preal97/VMCB/Doku/BACKSIDE.PNG

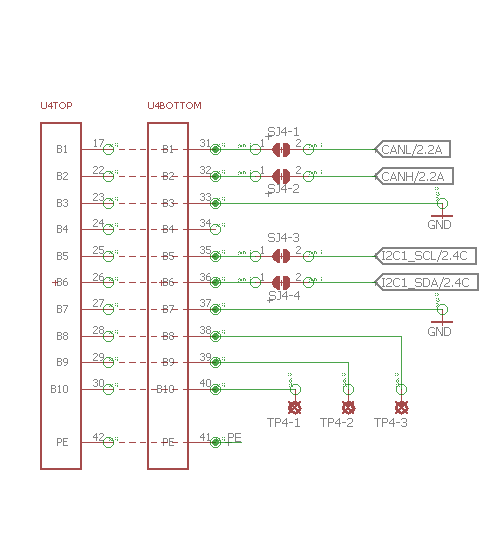
Doku/BACKSIDE.PNG
