preal97/VMCB/Doku/CANDIP.PNG

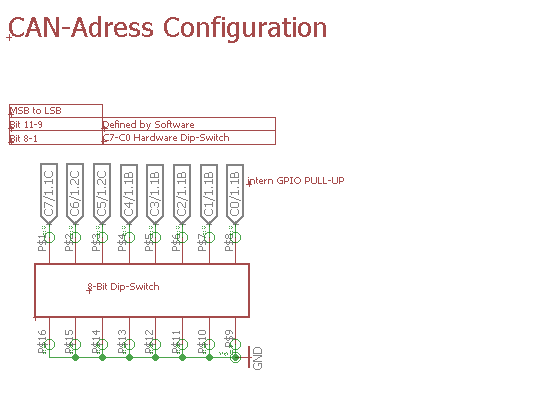
Doku/CANDIP.PNG
