preal97/VMCB/Doku/LED.PNG

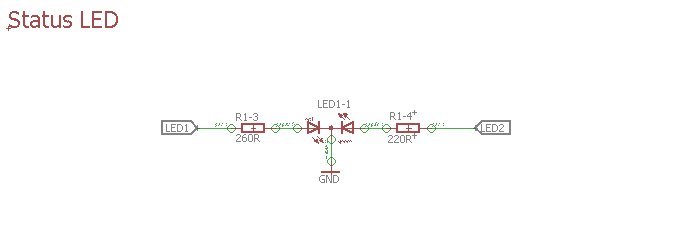
Doku/LED.PNG
