preal97/VMCB/Doku/MAX.PNG

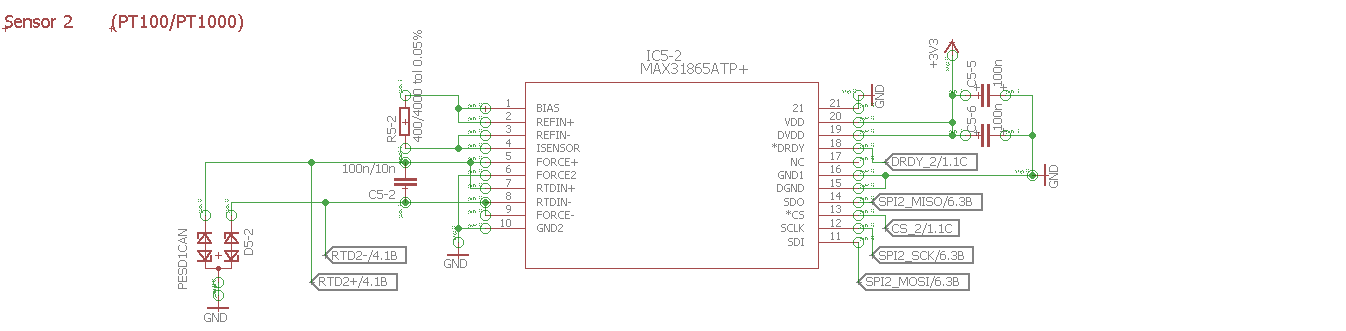
Doku/MAX.PNG
