preal97/VMCB/Doku/UART Temperatur.PNG

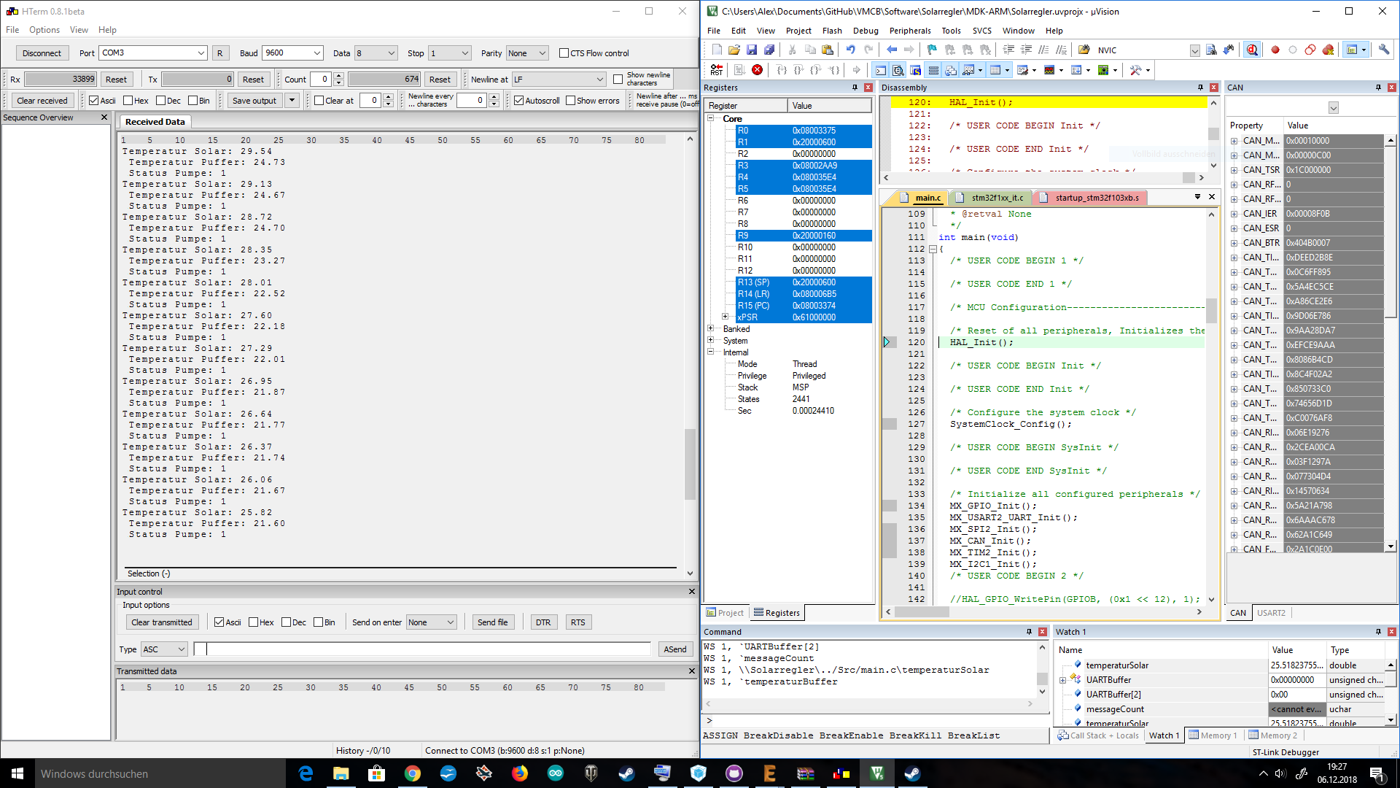
Doku/UART Temperatur.PNG
