preal97/VMCB/Doku/UART.PNG

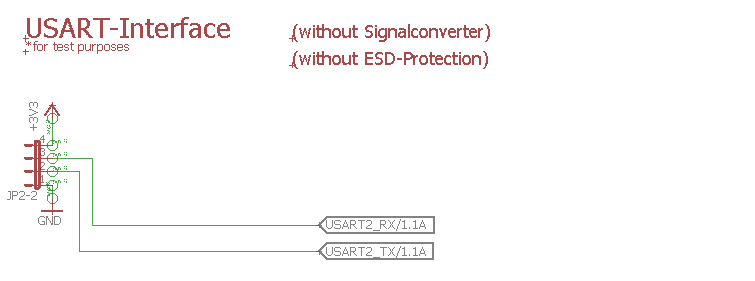
Doku/UART.PNG
