preal97/VMCB/Doku/Bauteilliste Solarregler V0.1.xlsx

Sheet: Reihenfolge nach Seitenzahl
Lfd. Nummer | Name | Wert | Bauform
1 | C1-1 | 100n | 603 | 1
2 | C1-2 | 100n | 603 | 1
3 | C1-3 | 100n | 603 | 1
4 | C1-4 | 4µ7 | 1206 | 1
5 | C1-5 | 100n | 603 | 1
6 | C1-6 | 18p | 603 | 1
7 | C1-7 | 18p | 603 | 1
8 | C1-8 | 1µ | 805 | 1
9 | C1-9 | 10n | 603 | 1
10 | C1-10 | 12p | 603 | 1
11 | C1-11 | 12p | 603 | 1
12 | R1-1 | 1M | 603 | 1
13 | R1-2 | 1M | 603 | 1
14 | R1-3 | 260R | 603 | 1
15 | R1-4 | 220R | 603 | 1
16 | Q1-1 | 8 MHz | SMD 6 x 3,5 mm | 1
17 | Q1-2 | 32.768kHz | RTC Through Hole | 1
18 | LED1-1 | green-red | common cathode dual led 5mm through hole | 1
19 | IC1 | STM32F105RBT6 | TQFP64 | 1
20 | IC2-1 | MCP2551-E/SN or SN65HVD230D | SOIC - 8 | 1
21 | C2-1 | 100n | 603 | 1
22 | R2-1 | 0R | 603 | 1
23 | R2-2 | 10k - 100k dependent on slew rate | 603 | 1
24 | R2-3 | 0R | 603 | 1
25 | R2-4 | 120R | 603 | 1
26 | JP2-1 | 2 Pin | 2 Pin * 2.54mm | 1
27 | DIP21 | 8-Bit DIP Switch | SMD | 1
28 | R2-5 | 10k | 603 | 1
29 | R2-6 | 10k | 603 | 1
30 | R2-7 | 10k | 603 | 1
31 | R2-8 | 10k | 603 | 1
32 | R2-9 | 1k | 603 | 1
33 | R2-10 | 1k | 603 | 1
34 | C2-2 | 100n | 603 | 1
35 | IC2-3 | PRTR5V0U4D | SC74 | 1
36 | JP2-2 | 4 Pin | 4 Pin linear * 2.54mm | 1
37 | VAR3-1 | VARISTORCN1210 | CT/CN1210 | 1
38 | VAR3-2 | VARISTORCN1210 | CT/CN1210 | 1
39 | VAR3-3 | VARISTORCN1210 | CT/CN1210 | 1
40 | F3-1 | 50 mA | 1210 | 1
41 | F3-2 | 50 mA | SHK20Q | 1
42 | D3-1 | B360B-13-F | SMB | 1
43 | D3-2 | SMAJ30CA | DO214AA | 1
44 | C3-1 | 10µ / 35V | 805 | 1
45 | C3-2 | 100n | 603 | 1
46 | C3-3 | 100n | 603 | 1
47 | JP3-1 | 3 Pin | 3 Pin linear * 2.54mm | 1
48 | IC3-1 | DC/DC 24V->3.3V | 4SIL | 1
49 | IC3-2 | Linear 5->3.3 | SOT223 | 1
50 | C3-4 | 100n | 603 | 1
51 | C3-5 | 22u / X7R | 805 | 1
52 | D3-3 | Schottky | MELF | 1
53 | T3-1 | PDTC124EU | SOT323 | 1
54 | K3-1 | Finder 34.51 5V | Finder 34 | 1
55 | U4CON1 | Phoenix Contact | Top Contacts DIN Rail
56 | U4CON2 | Phoenix Contact | Top Contacts DIN Rail
57 | U4CON3 | Phoenix Contact | Bottom Contacts DIN Rail
58 | U4CON4 | Phoenix Contact | Bottom Contacts DIN Rail
59 | IC5-1 | MAX31865ATP+ | T2055-5 | 1
60 | R5-1 | 400R/4k low tolerance | 603 | 1
61 | C5-1 | 100n / 10n | 603 | 1
62 | C5-3 | 100n | 603 | 1
63 | C5-4 | 100n | 603 | 1
64 | D5-1 | PESD1CAN / PESD2CAN | SOT23 | 1
65 | IC5-2 | MAX31865ATP+ | T2055-5 | 1
66 | R5-2 | 400R/4k low tolerance | 603 | 1
67 | C5-2 | 100n / 10n | 603 | 1
68 | C5-5 | 100n | 603 | 1
69 | C5-6 | 100n | 603 | 1
70 | D5-2 | PESD1CAN / PESD2CAN | SOT23 | 1
71 | IC6-1 | MAX31865ATP+ | T2055-5 | 1
72 | R6-1 | 400R/4k low tolerance | 603 | 1
73 | C6-1 | 100n / 10n | 603 | 1
74 | C6-2 | 100n | 603 | 1
75 | C6-3 | 100n | 603 | 1
76 | D6-1 | PESD1CAN / PESD2CAN | SOT23 | 1
77
78

Sheet: Tabelle2
Lfd. Nummer | Bauteil | Wert | Bestückung | Anzahl | vorhanden / zu bestellen |  | Link
1 | R 0603 | 1M | R1-1, R1-2 | 2 | v
2 | R 0603 | 260R | R1-3 | 1 | b
3 | R 0603 | 220R | R1-4 | 1 | v
4 | R 0603 | 0R | R2-1, R2-3 | 2 | v
5 | R 0603 | 10k - 100k (slew rate) | R2-2 | 1 | v
6 | R 0603 | 120R | R2-4 | 1 | v
7 | R 0603 | 10k | R2-5, R2-6, R2-7, R2-8 | 4 | v
8 | R 0603 | 1k | R2-9, R2-10 | 2 | v
9 | R 0603 | 400R/4k 0.05% | R5-1, R5-2, R6-1 | 3 | b |  | https://www.conrad.de/de/microtech-cmf0603402r0110-duennschicht-widerstand-402-smd-0603-01-w-01-10-ppm-1-st-1457041.html
10 | C 0603 | 100n | C1-1, C1-2, C1-3, C1-5, C2-1, C2-2, C3-2, C3-3, C3-4, C5-3, C5-4, C5-5, C5-6, C6-2, C6-3 | 15 | v
11 | C 0603 | 18p | C1-6, C1-7 | 2 | v
12 | C 0603 | 10n | C1-9 | 1 | v
13 | C 0603 | 12p | C1-10, C1-11 | 2 | v
14 | C 0603 | 10n/100n | C5-1, C5-2, C6-1 | 3 | v
15 | C 0805 | 1µ | C1-8 | 1 | v
16 | C 0805 | 10µ / 35V | C3-1 | 1 | v/b |  | https://de.rs-online.com/web/p/keramik-multilayer-kondensatoren/9159328/
17 | C 0805 | 22µ / X7R | C3-5 | 1 | b |  | https://www.conrad.de/de/tantal-kondensator-smd-22-f-63-v-20-l-x-b-35-mm-x-28-mm-panasonic-6tpu22msi-1-st-1479548.html
18 | C 1206 | 4µ7 | C1-4 | 1 | b |  | https://www.conrad.de/de/yageo-cc1206zpy5v7bb475-keramik-kondensator-smd-1206-47-f-16-v-20-1-st-445372.html
19 | Quarz SMD 6 x 3,5 mm | 8 MHz | Q1-1 | 1 | b |  | https://de.rs-online.com/web/p/quarzmodule/1710659/
20 | Quarz TH | 32.768kHz | Q1-2 | 1 | b |  | https://www.conrad.de/de/quarzkristall-euroquartz-quarz-tc26-zylinder-32768-khz-125-pf-o-x-h-2-mm-x-62-mm-1-st-156007.html
21 | B360B-13-F SMB |  | D3-1, D3-3 | 2 | b |  | https://www.conrad.de/de/panjit-schottky-diode-gleichrichter-sr36-do-214aa-60-v-einzeln-1304924.html
22 | SMAJ30CA |  | D3-2 | 1 | b |  | https://www.conrad.de/de/tvs-diode-bourns-smaj30ca-do-214ac-333-v-400-w-1056305.html
23 | Schottky MELF |  |  | 0 | v |  | //
24 | PESD2CAN/PESD1CAN |  | D5-1, D5-2, D6-1 | 3 | b |  | https://www.conrad.de/de/tvs-diode-nexperia-pesd2can215-sot-23-262-v-230-w-1096200.html
25 | Dual LED R/G COMCATH | 5mm | LED1-1 | 1 | v
26 | STM32F105RBT6 TQFP64 |  | IC1 | 1 | v
27 | MCP2551-E/SN or SN65HVD230D |  | IC2-1 | 1 | v
28 | PRTR5V0U4D SC74 |  | IC2-3 | 1 | b |  | https://www.conrad.de/de/tvs-diode-stmicroelectronics-dviulc6-4sc6y-sot-23-6l-6-v-1183886.html
29 | DC/DC 24V->5V 4SIL |  | IC3-1 | 1 | b/v | IE2405S oder TME2405S | https://www.conrad.de/de/tracopower-tme-2405s-dcdc-wandler-print-24-vdc-5-vdc-200-ma-1-w-anzahl-ausgaenge-1-x-154477.html
30 | MIC5209 5V->3.3V |  | IC3-2 | 1 | v
31 | MAX31865ATP+ T2055-5 |  | IC5-1, IC5-2, IC6-1 | 3 | b/v |  | https://www.conrad.de/de/pmic-waermemanagement-maxim-integrated-max31865atp-extern-spi-tqfn-20-ep-5x5-1123421.html
32 | 8-Bit DIP Switch SMD |  | DIP21 | 1 | b |  | https://www.conrad.de/de/dip-schalter-polzahl-8-smd-apem-ikh0803000-1-st-700772.html
33 | VARISTORCN1210 CT/CN1210 |  | VAR3-1, VAR3-2, VAR3-3 | 3 | b |  | https://de.rs-online.com/web/p/metalloxid-varistoren/7606961/
34 | SMD FUSE 1210 |  | F3-1 | 1 | b |  | https://de.rs-online.com/web/p/rueckstellende-sicherungen-smd/6478342/
35 | 50mA SHK20Q |  | F3-2 | 1 | b
36 | Finder Series 34.51 5V |  | K3-1 | 1 | b |  | https://www.conrad.de/de/finder-361190054011-printrelais-5-vdc-10-a-1-wechsler-1-st-503243.html
37 | 2.54mm Pin Header |  | JP2-1, JP2-2, JP3-1 | 3 | b
38 | Phoenix Contact Top Contact |  | U4CON1, U4CON2 | 2 | b
38 | Phoenix Contact Bottom Contact |  | U4CON3, U4CON4 | 2 | b
