preal97/VMCB/Hardware/Solarregler v0.2/Solarregler.pdf

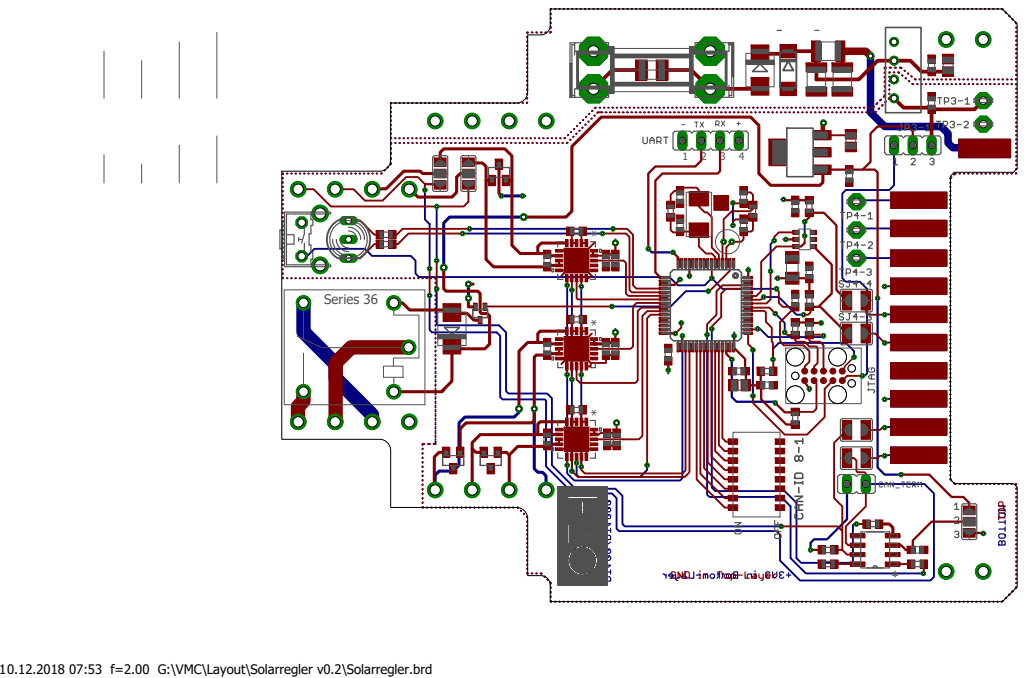
[picture p21: page 1]
Series 36

10.12.2018 07:53 f=2.00 G:\VMC\Layout\Solarregler v0.2\Solarregler.brd
