preal97/VMCB/Hardware/Solarregler v0.1/Solarregler.pdf

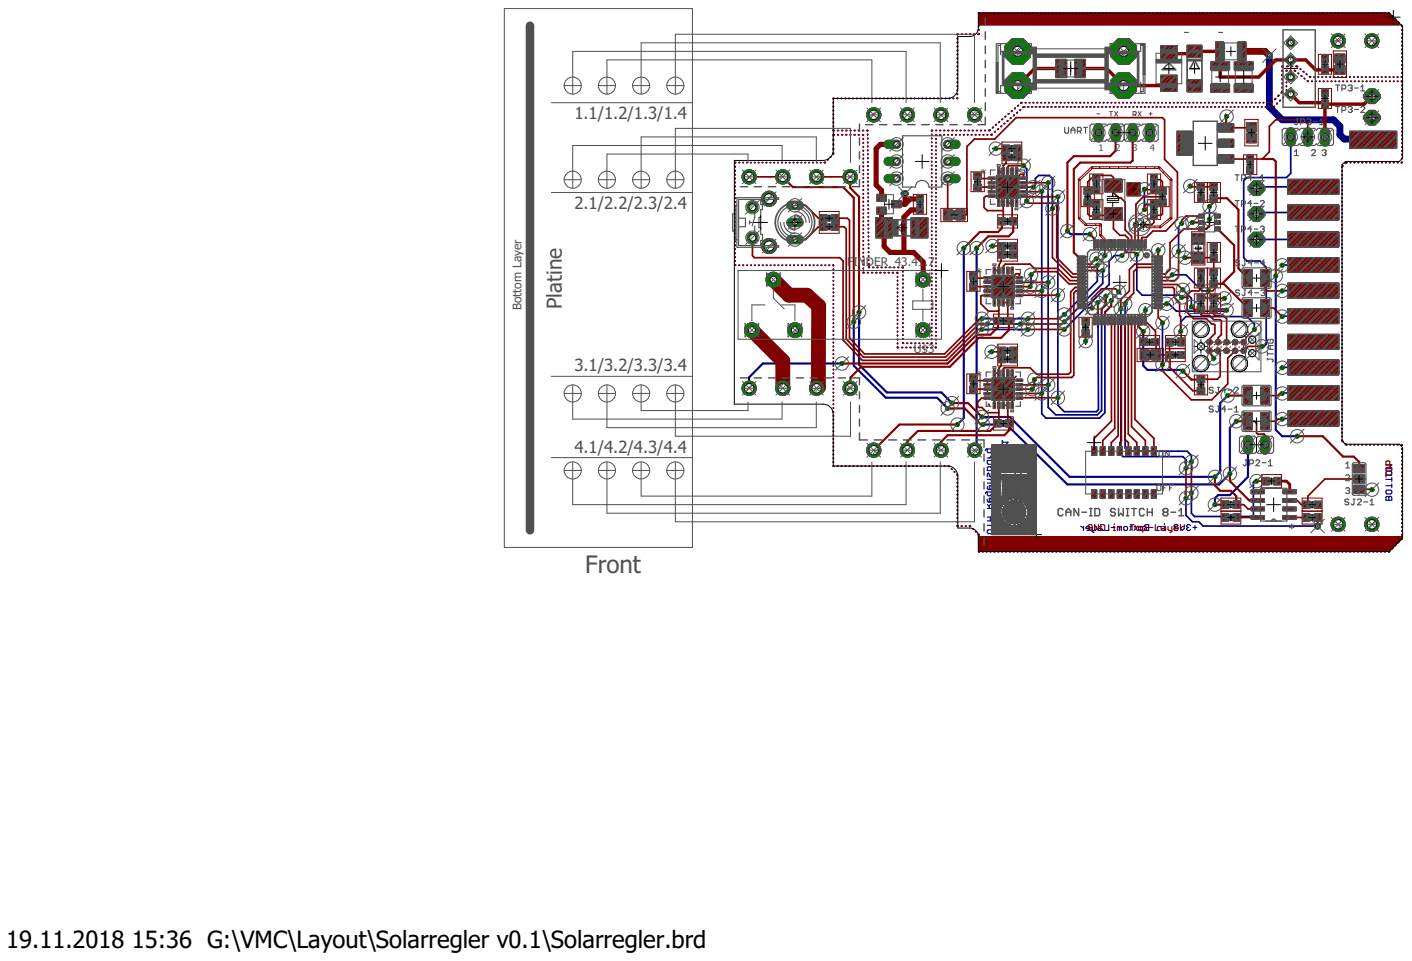
[picture p22: page 1]

19.11.2018 15:36 G:\VMC\Layout\Solarregler v0.1\Solarregler.brd
