preal97/VMCB/Hardware/Solarregler v0.2/Solarregler.brd

## EAGLE design Hardware/Solarregler v0.2/Solarregler.brd (2018-12-10)

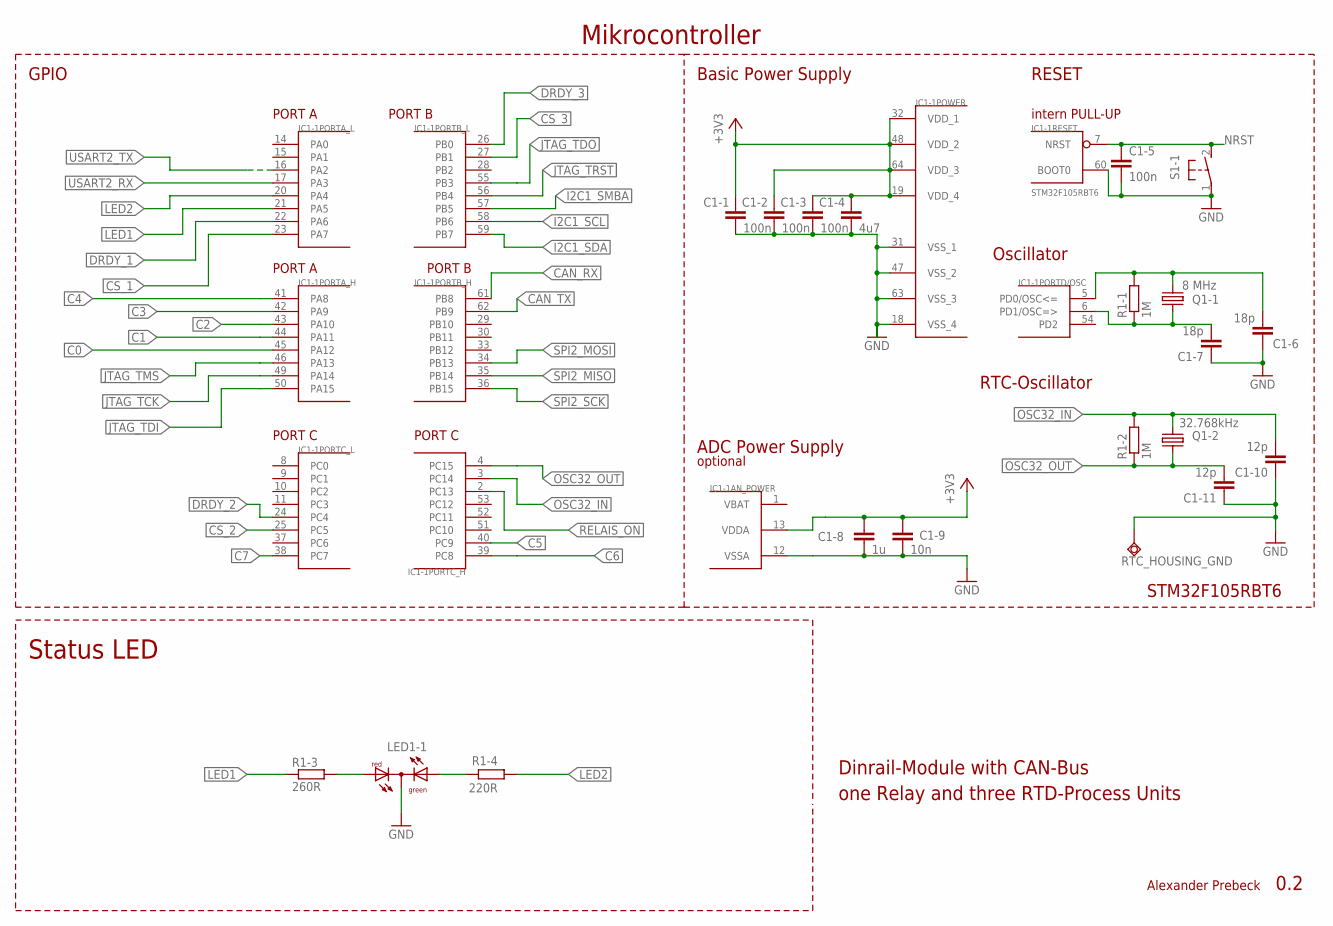
[picture p23: schematic Solarregler.sch, sheet 1]

Parts:
C1-1, C1-2, C1-3, C1-5: 100n; C0603; MPN C0805C104K1RAC AUTO
C1-4: 4u7; C1206; MPN GRM21BR61A475KA73L
C1-6, C1-7: 18p; C0603; MPN C0805C270J5GACTU
C1-8: 1u; C0805; MPN GRM21BR71E105KA99L
C1-9: 10n; C0603; MPN MC0805B103K500CT
C1-10, C1-11: 12p; C0603; MPN C0805C270J5GACTU
IC1-1: STM32F105RBT6; TQFP64
LED1-1: DUOLED-RG-C; DUOLED-C-5MM
Q1-1: 8 MHz; SMD_QUARZ_6X3.5MM
Q1-2: 32.768kHz; THROUGH_HOLE_QUARZ_RTC
R1-1, R1-2: 1M; R0603
R1-3: 260R; R0603
R1-4: 220R; R0603
RTC_HOUSING_GND: TPSQTP20SQ; TP20SQ
S1-1: 31-XX; B3F-31XX

Connections:
+3V3: C1-1.1, C1-2.1, C1-3.1, C1-4.1, C1-8.1, C1-9.1, IC1-1.13 (VDDA), IC1-1.19 (VDD_4), IC1-1.32 (VDD_1), IC1-1.48 (VDD_2), IC1-1.64 (VDD_3); also elsewhere on the board
C0: IC1-1.45 (PA12); also elsewhere on the board
C1: IC1-1.44 (PA11); also elsewhere on the board
C2: IC1-1.43 (PA10); also elsewhere on the board
C3: IC1-1.42 (PA9); also elsewhere on the board
C4: IC1-1.41 (PA8); also elsewhere on the board
C5: IC1-1.40 (PC9); also elsewhere on the board
C6: IC1-1.39 (PC8); also elsewhere on the board
C7: IC1-1.38 (PC7); also elsewhere on the board
CAN_RX: IC1-1.61 (PB8); also elsewhere on the board
CAN_TX: IC1-1.62 (PB9); also elsewhere on the board
CS_1: IC1-1.23 (PA7); also elsewhere on the board
CS_2: IC1-1.25 (PC5); also elsewhere on the board
CS_3: IC1-1.27 (PB1); also elsewhere on the board
DRDY_1: IC1-1.22 (PA6); also elsewhere on the board
DRDY_2: IC1-1.24 (PC4); also elsewhere on the board
DRDY_3: IC1-1.26 (PB0); also elsewhere on the board
GND: C1-1.2, C1-2.2, C1-3.2, C1-4.2, C1-5.2, C1-6.1, C1-7.1, C1-8.2, C1-9.2, C1-10.1, C1-11.1, IC1-1.12 (VSSA), IC1-1.18 (VSS_4), IC1-1.31 (VSS_1), IC1-1.47 (VSS_2), IC1-1.60 (BOOT0), IC1-1.63 (VSS_3), LED1-1.C, RTC_HOUSING_GND.TP, S1-1.1; also elsewhere on the board
I2C1_SCL: IC1-1.58 (PB6); also elsewhere on the board
I2C1_SDA: IC1-1.59 (PB7); also elsewhere on the board
I2C1_SMBA: IC1-1.57 (PB5); also elsewhere on the board
JTAG_TCK: IC1-1.49 (PA14); also elsewhere on the board
JTAG_TDI: IC1-1.50 (PA15); also elsewhere on the board
JTAG_TDO: IC1-1.55 (PB3); also elsewhere on the board
JTAG_TMS: IC1-1.46 (PA13); also elsewhere on the board
JTAG_TRST: IC1-1.56 (PB4); also elsewhere on the board
LED1: IC1-1.21 (PA5), R1-3.1
LED2: IC1-1.20 (PA4), R1-4.1
unnamed: LED1-1.AX (AG), R1-4.2
unnamed: LED1-1.AR, R1-3.2
unnamed: C1-7.2, IC1-1.6 (PD1/OSC=>), Q1-1.1, R1-1.1
unnamed: C1-6.2, IC1-1.5 (PD0/OSC<=), Q1-1.2, R1-1.2
NRST: C1-5.1, IC1-1.7 (NRST), S1-1.2 (S); also elsewhere on the board
OSC32_IN: C1-10.2, IC1-1.3 (PC14), Q1-2.P$1 (1), R1-2.2
OSC32_OUT: C1-11.2, IC1-1.4 (PC15), Q1-2.P$2 (2), R1-2.1
RELAIS_ON: IC1-1.2 (PC13); also elsewhere on the board
SPI2_MISO: IC1-1.35 (PB14); also elsewhere on the board
SPI2_MOSI: IC1-1.34 (PB13); also elsewhere on the board
SPI2_SCK: IC1-1.36 (PB15); also elsewhere on the board
USART2_RX: IC1-1.17 (PA3); also elsewhere on the board
USART2_TX: IC1-1.16 (PA2); also elsewhere on the board
VBAT: IC1-1.1 (VBAT)

Notes on the sheet:
Mikrocontroller
Dinrail-Module with CAN-Bus
one Relay and three RTD-Process Units
0.2
Status LED
Alexander Prebeck
intern PULL-UP
RESET
PORT A
PORT B
PORT C
GPIO
Oscillator
ADC Power Supply
Basic Power Supply
STM32F105RBT6
RTC-Oscillator
optional

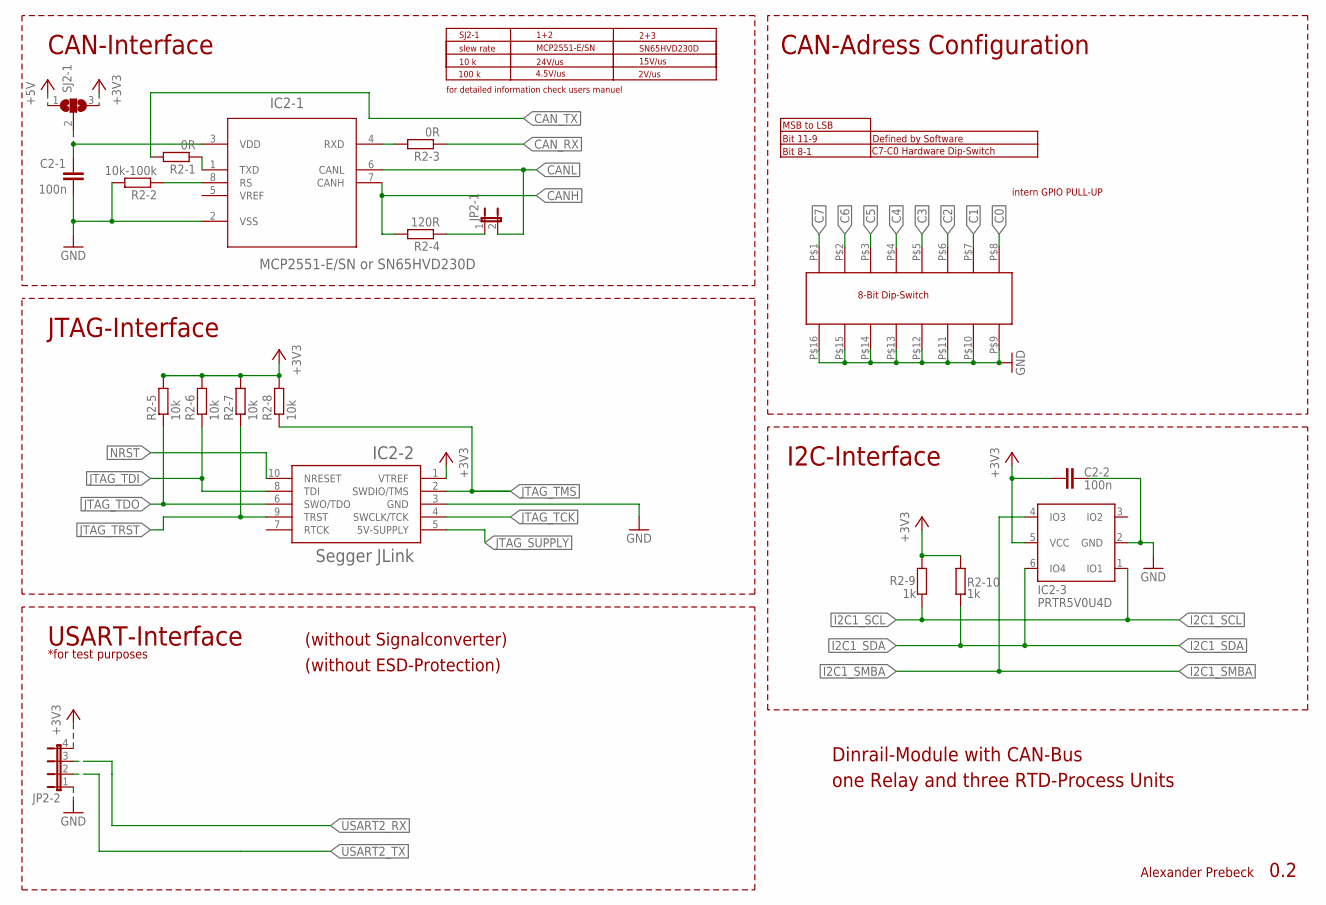
[picture p24: schematic Solarregler.sch, sheet 2]

Parts:
C2-1, C2-2: 100n; C0603; MPN C0805C104K1RAC AUTO
DIP21: MULTICOMP
IC2-1: MCP2551-E/SN or SN65HVD230D; SOIC127P600X175-8N
IC2-2: J-LINK-10PIN-HOLES
IC2-3: PRTR5V0U4D; SC74; MPN PRTR5V0U4D,125.
JP2-1: JP1E; JP1
JP2-2: JP4E; JP4
R2-1, R2-3: 0R; R0603
R2-2: 10k-100k; R0603
R2-4: 120R; R0603
R2-5, R2-6, R2-7, R2-8: 10k; R0603
R2-9, R2-10: 1k; R0603
SJ2-1: SJ2W; SJ_2

Connections:
+3V3: C2-2.1, IC2-2.1 (VTREF), IC2-3.5 (VCC), JP2-2.4, R2-5.2, R2-6.2, R2-7.2, R2-8.2, R2-9.2, R2-10.2, SJ2-1.3; also elsewhere on the board
+5V: SJ2-1.1; also elsewhere on the board
C0: DIP21.P$8; also elsewhere on the board
C1: DIP21.P$7; also elsewhere on the board
C2: DIP21.P$6; also elsewhere on the board
C3: DIP21.P$5; also elsewhere on the board
C4: DIP21.P$4; also elsewhere on the board
C5: DIP21.P$3; also elsewhere on the board
C6: DIP21.P$2; also elsewhere on the board
C7: DIP21.P$1 (1); also elsewhere on the board
CANH: IC2-1.7 (CANH), R2-4.2; also elsewhere on the board
CANL: IC2-1.6 (CANL), JP2-1.2; also elsewhere on the board
CAN_RX: R2-3.1; also elsewhere on the board
CAN_TERM2: JP2-1.1, R2-4.1
CAN_TX: R2-1.2; also elsewhere on the board
GND: C2-1.2, C2-2.2, DIP21.P$9, DIP21.P$10, DIP21.P$11, DIP21.P$12, DIP21.P$13, DIP21.P$14, DIP21.P$15, DIP21.P$16, IC2-1.2 (VSS), IC2-2.3 (GND), IC2-3.2 (GND), JP2-2.1, R2-2.2; also elsewhere on the board
I2C1_SCL: IC2-3.1 (IO1), R2-9.1; also elsewhere on the board
I2C1_SDA: IC2-3.6 (IO4), R2-10.1; also elsewhere on the board
I2C1_SMBA: IC2-3.4 (IO3); also elsewhere on the board
JTAG_SUPPLY: IC2-2.5 (5V-SUPPLY); also elsewhere on the board
JTAG_TCK: IC2-2.4 (SWCLK/TCK); also elsewhere on the board
JTAG_TDI: IC2-2.8 (TDI), R2-6.1; also elsewhere on the board
JTAG_TDO: IC2-2.6 (SWO/TDO), R2-5.1; also elsewhere on the board
JTAG_TMS: IC2-2.2 (SWDIO/TMS), R2-8.1; also elsewhere on the board
JTAG_TRST: IC2-2.9 (TRST), R2-7.1; also elsewhere on the board
unnamed: IC2-1.4 (RXD), R2-3.2
unnamed: IC2-1.1 (TXD), R2-1.1
unnamed: IC2-1.8 (RS), R2-2.1
unnamed: C2-1.1, IC2-1.3 (VDD), SJ2-1.2
NRST: IC2-2.10 (NRESET); also elsewhere on the board
USART2_RX: JP2-2.3; also elsewhere on the board
USART2_TX: JP2-2.2; also elsewhere on the board

Notes on the sheet:
CAN-Interface
I2C-Interface
JTAG-Interface
USART-Interface
Dinrail-Module with CAN-Bus
0.2
one Relay and three RTD-Process Units
Alexander Prebeck
*for test purposes
slew rate
MCP2551-E/SN
SN65HVD230D
10 k
100 k
24V/us
4.5V/us
15V/us
2V/us
for detailed information check users manuel
SJ2-1
1+2
2+3
CAN-Adress Configuration
Bit 8-1
Bit 11-9
C7-C0 Hardware Dip-Switch
Defined by Software
MSB to LSB
intern GPIO PULL-UP
8-Bit Dip-Switch
(without Signalconverter)
(without ESD-Protection)

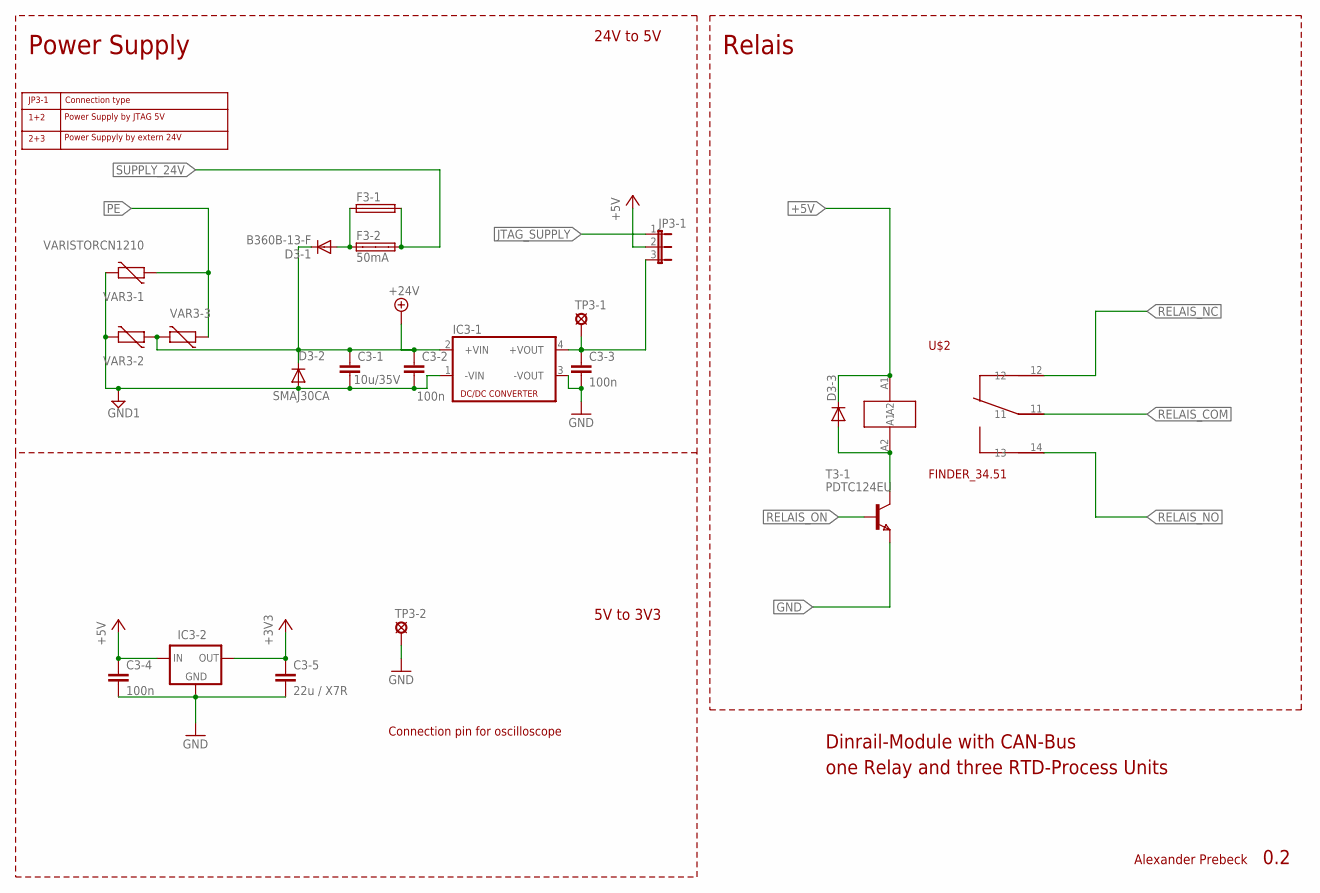
[picture p25: schematic Solarregler.sch, sheet 3]

Parts:
C3-1: 10u/35V; C0805; MPN GRM31CC8YA106KA12L
C3-2, C3-3, C3-4: 100n; C0603; MPN C0805C104K1RAC AUTO
C3-5: 22u / X7R; C0805; MPN C0805C104K1RAC AUTO
D3-1: B360B-13-F; SMB; MPN B360B-13-F
D3-2: SMAJ30CA; DO214AA; MPN SMAJ30CA
D3-3: DIODE-SMB; SMB
F3-1: FUSE_1210; 1210
F3-2: 50mA; SHK20Q; MPN 0031.8201
IC3-1: SIM1; 4SIL; MPN IE2405S
IC3-2: MIC5209; SOT223; MPN MIC5209-3.3YS TR
JP3-1: JP2E; JP2
T3-1: PDTC124EU; SOT323
TP3-1, TP3-2: LSP10
U$2: FINDER_34.51; SERIES_34
VAR3-1, VAR3-2, VAR3-3: VARISTORCN1210; CT/CN1210; MPN VC121030H620DP

Connections:
+3V3: C3-5.1, IC3-2.3 (OUT); also elsewhere on the board
+5V: C3-4.1, D3-3.C, IC3-2.1 (IN), JP3-1.2, U$2.A1; also elsewhere on the board
+24V: C3-1.1, C3-2.1, D3-1.C, D3-2.C, IC3-1.2 (+VIN), VAR3-2.2, VAR3-3.2
GND: C3-3.2, C3-4.2, C3-5.2, IC3-1.3 (-VOUT), IC3-2.2 (GND), IC3-2.4 (GND), T3-1.3 (E), TP3-2.MP; also elsewhere on the board
GND1: C3-1.2, C3-2.2, D3-2.A, IC3-1.1 (-VIN), VAR3-1.1, VAR3-2.1; also elsewhere on the board
JTAG_SUPPLY: JP3-1.1; also elsewhere on the board
unnamed: D3-3.A, T3-1.1 (C), U$2.A2
unnamed: C3-3.1, IC3-1.4 (+VOUT), JP3-1.3, TP3-1.MP
unnamed: D3-1.A, F3-1.1, F3-2.1A
PE: VAR3-1.2, VAR3-3.1; also elsewhere on the board
RELAIS_COM: U$2.11; also elsewhere on the board
RELAIS_NC: U$2.12; also elsewhere on the board
RELAIS_NO: U$2.14 (13); also elsewhere on the board
RELAIS_ON: T3-1.2 (B); also elsewhere on the board
SUPPLY_24V: F3-1.2, F3-2.2A; also elsewhere on the board

Notes on the sheet:
Power Supply
Connection pin for oscilloscope
24V to 5V
5V to 3V3
JP3-1
1+2
2+3
Power Supply by JTAG 5V
Power Suppyly by extern 24V
Connection type
Relais
0.2
Dinrail-Module with CAN-Bus
one Relay and three RTD-Process Units
Alexander Prebeck

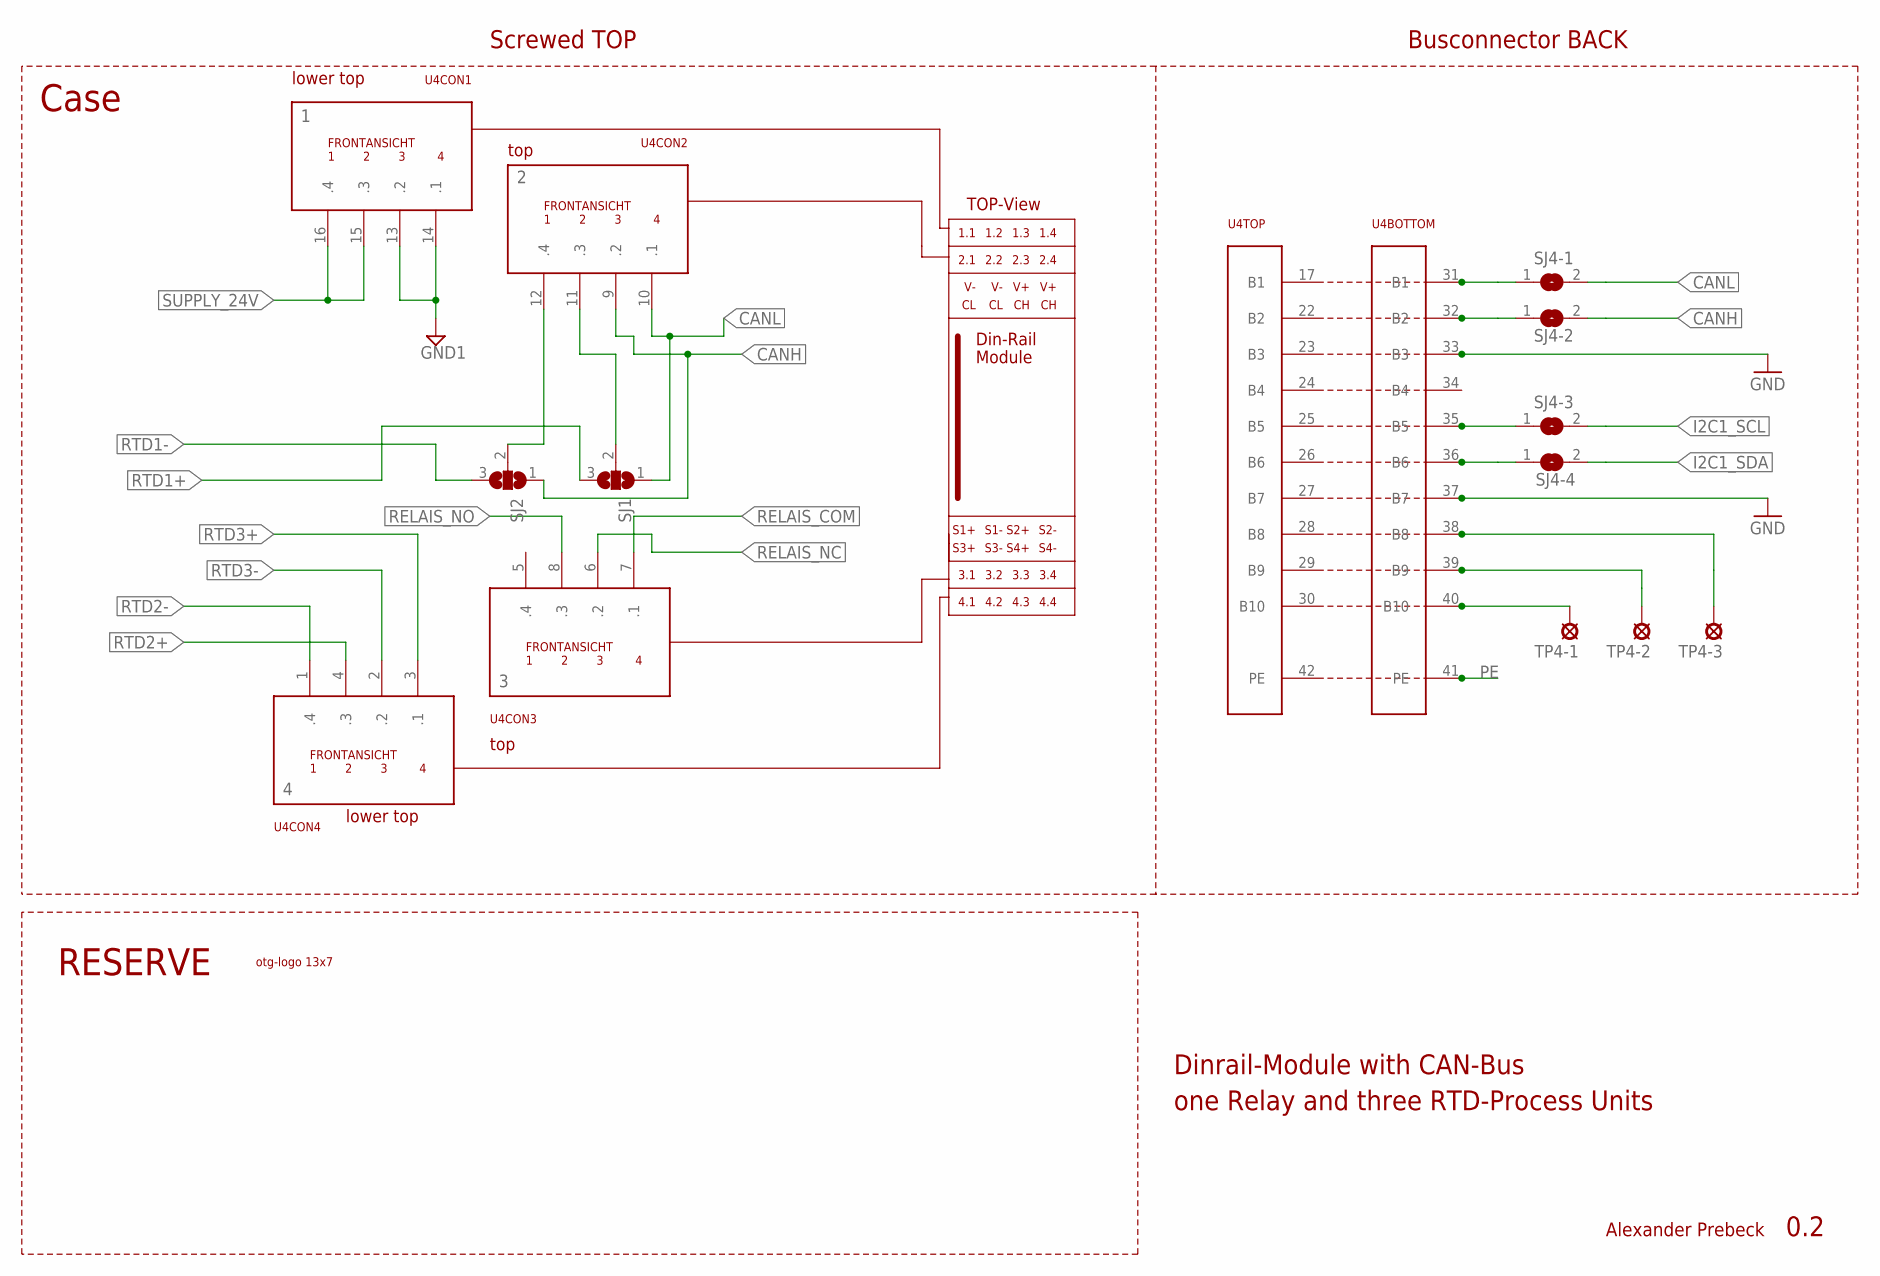
[picture p26: schematic Solarregler.sch, sheet 4]

Parts:
SJ1, SJ2: SJ2W; SJ_2
SJ4-1, SJ4-2, SJ4-3, SJ4-4: SJW
TP4-1, TP4-2, TP4-3: LSP10
U4: HUTSCHIENE_DEV; HUTSCHIENE
U$1: OTH-LOGO13X7; OTH-LOGO_SMALL

Connections:
CANH: SJ2.1, SJ4-2.2, U4.9 (.2); also elsewhere on the board
CANL: SJ1.1, SJ4-1.2, U4.10 (.1); also elsewhere on the board
GND: U4.33 (B3), U4.37 (B7); also elsewhere on the board
GND1: U4.13 (.2), U4.14 (.1); also elsewhere on the board
I2C1_SCL: SJ4-3.2; also elsewhere on the board
I2C1_SDA: SJ4-4.2; also elsewhere on the board
unnamed: SJ1.2, U4.11 (.3)
unnamed: SJ2.2, U4.12 (.4)
unnamed: SJ4-1.1, U4.31 (B1)
unnamed: SJ4-2.1, U4.32 (B2)
unnamed: SJ4-3.1, U4.35 (B5)
unnamed: SJ4-4.1, U4.36 (B6)
unnamed: TP4-3.MP, U4.38 (B8)
unnamed: TP4-2.MP, U4.39 (B9)
unnamed: TP4-1.MP, U4.40 (B10)
PE: U4.41 (PE); also elsewhere on the board
RELAIS_COM: U4.7 (.1); also elsewhere on the board
RELAIS_NC: U4.6 (.2); also elsewhere on the board
RELAIS_NO: U4.8 (.3); also elsewhere on the board
RTD1+: SJ1.3; also elsewhere on the board
RTD1-: SJ2.3; also elsewhere on the board
RTD2+: U4.4 (.3); also elsewhere on the board
RTD2-: U4.1 (.4); also elsewhere on the board
RTD3+: U4.3 (.1); also elsewhere on the board
RTD3-: U4.2 (.2); also elsewhere on the board
SUPPLY_24V: U4.15 (.3), U4.16 (.4); also elsewhere on the board

Notes on the sheet:
Case
lower top
top
Screwed TOP
Busconnector BACK
1.1
1.2
1.3
1.4
2.1
2.2
2.3
2.4
TOP-View
Din-Rail
Module
Dinrail-Module with CAN-Bus
0.2
one Relay and three RTD-Process Units
Alexander Prebeck
3.1
3.2
3.3
3.4
4.1
4.2
4.3
4.4
S1-
S1+
S3+
S2-
S2+
S4+
S4-
S3-
RESERVE

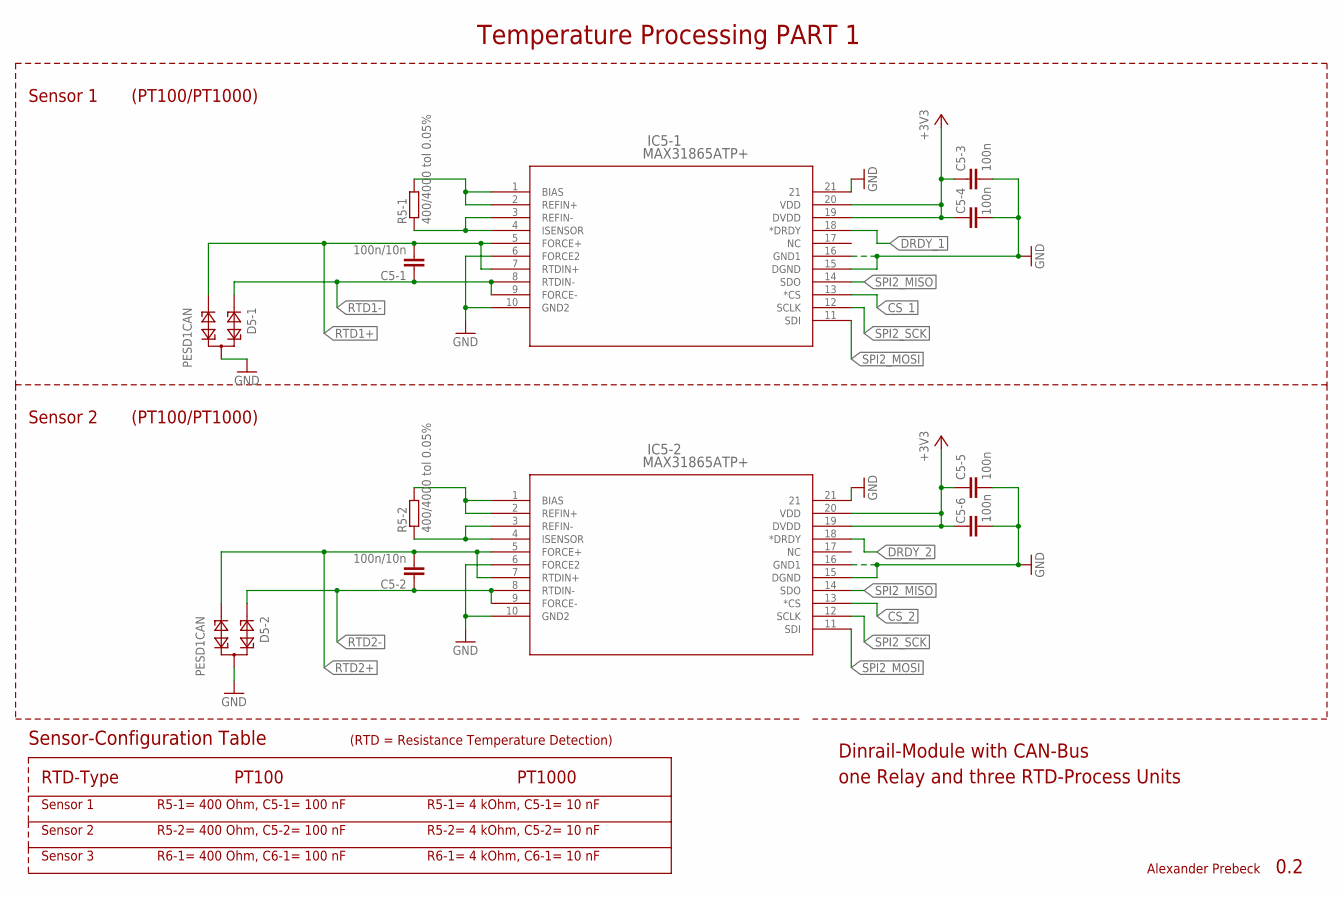
[picture p27: schematic Solarregler.sch, sheet 5]

Parts:
C5-1, C5-2: 100n/10n; C0603
C5-3, C5-4, C5-5, C5-6: 100n; C0603
D5-1, D5-2: PESD1CAN; SOT23
IC5-1, IC5-2: MAX31865ATP+; 21-0140L_T2055-5
R5-1, R5-2: 400/4000 tol 0.05%; R0603

Connections:
+3V3: C5-3.1, C5-4.1, C5-5.1, C5-6.1, IC5-1.19 (DVDD), IC5-1.20 (VDD), IC5-2.19 (DVDD), IC5-2.20 (VDD); also elsewhere on the board
CS_1: IC5-1.13 (*CS); also elsewhere on the board
CS_2: IC5-2.13 (*CS); also elsewhere on the board
DRDY_1: IC5-1.18 (*DRDY); also elsewhere on the board
DRDY_2: IC5-2.18 (*DRDY); also elsewhere on the board
GND: C5-3.2, C5-4.2, C5-5.2, C5-6.2, D5-1.3, D5-2.3, IC5-1.6 (FORCE2), IC5-1.10 (GND2), IC5-1.15 (DGND), IC5-1.16 (GND1), IC5-1.21, IC5-2.6 (FORCE2), IC5-2.10 (GND2), IC5-2.15 (DGND), IC5-2.16 (GND1), IC5-2.21; also elsewhere on the board
unnamed: IC5-1.1 (BIAS), IC5-1.2 (REFIN+), R5-1.2
unnamed: IC5-1.3 (REFIN-), IC5-1.4 (ISENSOR), R5-1.1
unnamed: IC5-2.1 (BIAS), IC5-2.2 (REFIN+), R5-2.2
unnamed: IC5-2.3 (REFIN-), IC5-2.4 (ISENSOR), R5-2.1
RTD1+: C5-1.2, D5-1.2, IC5-1.5 (FORCE+), IC5-1.7 (RTDIN+); also elsewhere on the board
RTD1-: C5-1.1, D5-1.1, IC5-1.8 (RTDIN-), IC5-1.9 (FORCE-); also elsewhere on the board
RTD2+: C5-2.2, D5-2.2, IC5-2.5 (FORCE+), IC5-2.7 (RTDIN+); also elsewhere on the board
RTD2-: C5-2.1, D5-2.1, IC5-2.8 (RTDIN-), IC5-2.9 (FORCE-); also elsewhere on the board
SPI2_MISO: IC5-1.14 (SDO), IC5-2.14 (SDO); also elsewhere on the board
SPI2_MOSI: IC5-1.11 (SDI), IC5-2.11 (SDI); also elsewhere on the board
SPI2_SCK: IC5-1.12 (SCLK), IC5-2.12 (SCLK); also elsewhere on the board

Notes on the sheet:
Temperature Processing PART 1
Sensor 1
Sensor 2
Dinrail-Module with CAN-Bus
0.2
one Relay and three RTD-Process Units
Alexander Prebeck
Sensor-Configuration Table
(PT100/PT1000)
(RTD = Resistance Temperature Detection)
PT100
PT1000
Sensor 3
R5-1= 400 Ohm, C5-1= 100 nF
R5-2= 400 Ohm, C5-2= 100 nF
R6-1= 400 Ohm, C6-1= 100 nF
R5-1= 4 kOhm, C5-1= 10 nF
R5-2= 4 kOhm, C5-2= 10 nF
R6-1= 4 kOhm, C6-1= 10 nF
RTD-Type

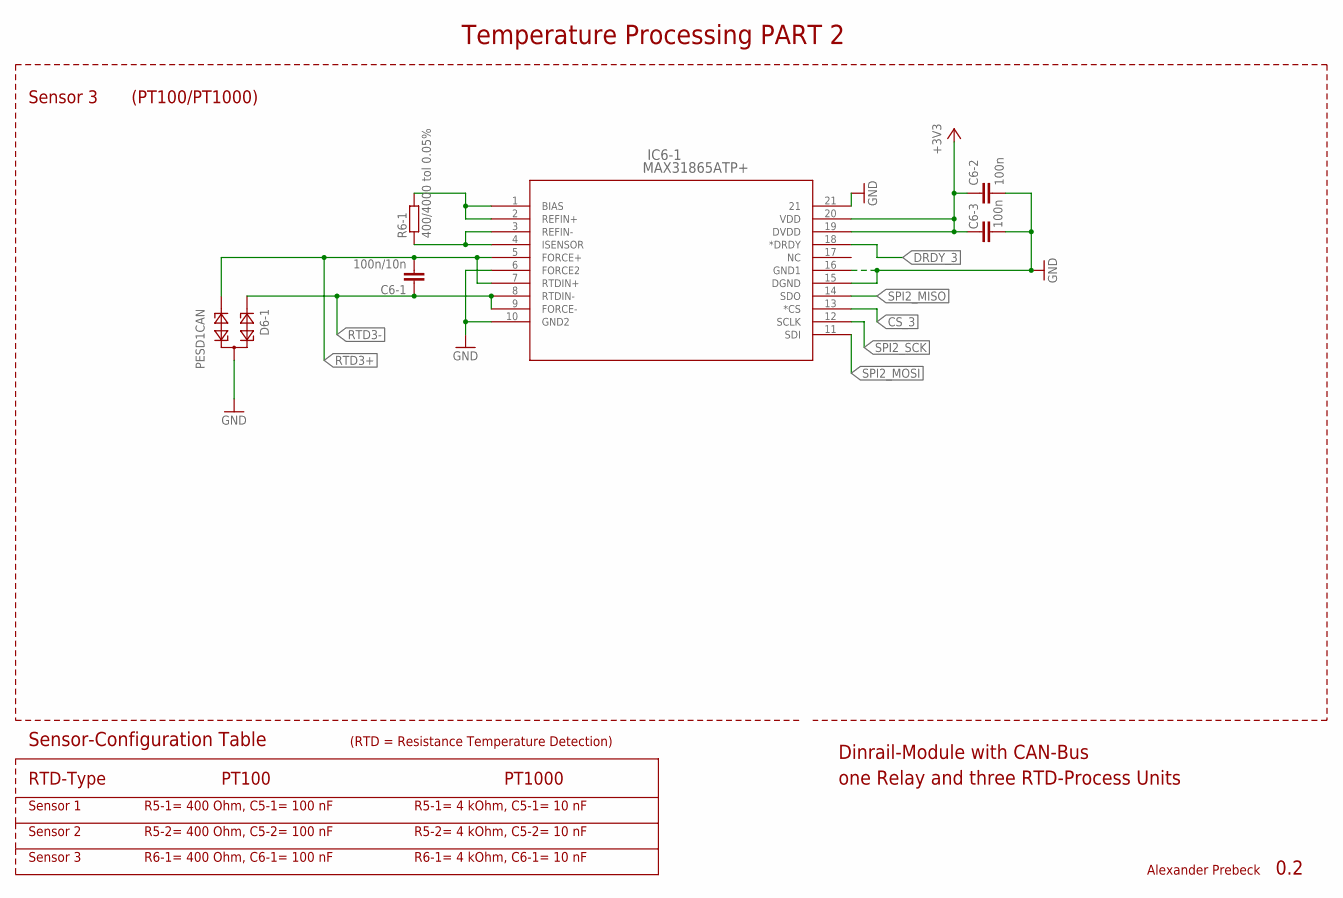
[picture p28: schematic Solarregler.sch, sheet 6]

Parts:
C6-1: 100n/10n; C0603
C6-2, C6-3: 100n; C0603
D6-1: PESD1CAN; SOT23
IC6-1: MAX31865ATP+; 21-0140L_T2055-5
R6-1: 400/4000 tol 0.05%; R0603

Connections:
+3V3: C6-2.1, C6-3.1, IC6-1.19 (DVDD), IC6-1.20 (VDD); also elsewhere on the board
CS_3: IC6-1.13 (*CS); also elsewhere on the board
DRDY_3: IC6-1.18 (*DRDY); also elsewhere on the board
GND: C6-2.2, C6-3.2, D6-1.3, IC6-1.6 (FORCE2), IC6-1.10 (GND2), IC6-1.15 (DGND), IC6-1.16 (GND1), IC6-1.21; also elsewhere on the board
unnamed: IC6-1.1 (BIAS), IC6-1.2 (REFIN+), R6-1.2
unnamed: IC6-1.3 (REFIN-), IC6-1.4 (ISENSOR), R6-1.1
RTD3+: C6-1.2, D6-1.2, IC6-1.5 (FORCE+), IC6-1.7 (RTDIN+); also elsewhere on the board
RTD3-: C6-1.1, D6-1.1, IC6-1.8 (RTDIN-), IC6-1.9 (FORCE-); also elsewhere on the board
SPI2_MISO: IC6-1.14 (SDO); also elsewhere on the board
SPI2_MOSI: IC6-1.11 (SDI); also elsewhere on the board
SPI2_SCK: IC6-1.12 (SCLK); also elsewhere on the board

Notes on the sheet:
Dinrail-Module with CAN-Bus
0.2
one Relay and three RTD-Process Units
Alexander Prebeck
Temperature Processing PART 2
Sensor 3
(PT100/PT1000)
Sensor-Configuration Table
Sensor 1
PT100
PT1000
Sensor 2
R5-1= 400 Ohm, C5-1= 100 nF
R5-2= 400 Ohm, C5-2= 100 nF
R6-1= 400 Ohm, C6-1= 100 nF
R5-1= 4 kOhm, C5-1= 10 nF
R5-2= 4 kOhm, C5-2= 10 nF
R6-1= 4 kOhm, C6-1= 10 nF
RTD-Type
(RTD = Resistance Temperature Detection)

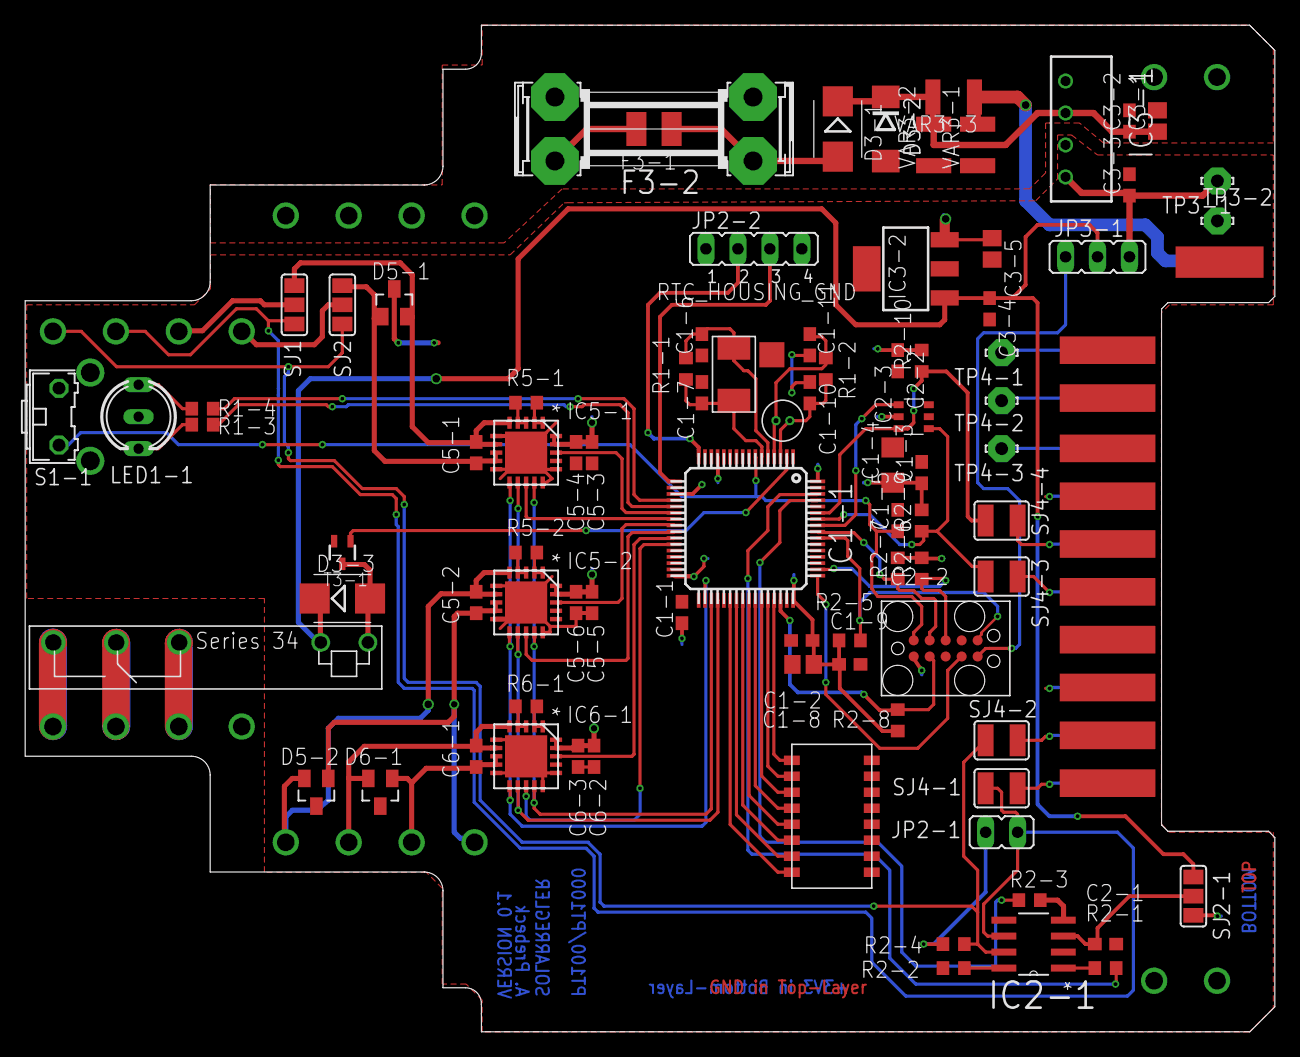
[picture p29: board Solarregler.brd from above]

Board: 2 copper layers, 99.3 x 80.0 mm, 89 parts (0 on the bottom side), 81 nets.
