preal97/VMCB/Software/Solarregler/Src/main.c

/**
  ******************************************************************************
  * @file           : main.c
  * @brief          : Main program body
  ******************************************************************************
  ** This notice applies to any and all portions of this file
  * that are not between comment pairs USER CODE BEGIN and
  * USER CODE END. Other portions of this file, whether 
  * inserted by the user or by software development tools
  * are owned by their respective copyright owners.
  *
  * COPYRIGHT(c) 2018 STMicroelectronics
  *
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
  ******************************************************************************
  */
/* Includes ------------------------------------------------------------------*/
#include "main.h"
#include "stm32f1xx_hal.h"

/* USER CODE BEGIN Includes */

#include "MAX31865.h"
#include "stdio.h"
#include "string.h"

/* USER CODE END Includes */

CAN_HandleTypeDef hcan;

RTC_HandleTypeDef hrtc;

SPI_HandleTypeDef hspi2;

TIM_HandleTypeDef htim2;

UART_HandleTypeDef huart2;

/* USER CODE BEGIN PV */

float temperaturSolar = 0.0;
float temperaturSens3 = 0.0;
float temperaturSolarMean = 0.0;
float temperaturBuffer = 0.0;
float temperaturBufferMean = 0.0;

float temperaturSolarMin = 50;
float temperaturBufferMax = 90;

float hysteresisON = 10.0;
float hysteresisOFF = 2.0;

float resistanceSolar = 0.0;
float resistanceBuffer  = 0.0;

MAX31865_TypeDef MAXSolar;
MAX31865_TypeDef MAXBuffer;
MAX31865_TypeDef MAXSens3;

uint8_t relaisState = 0;

uint8_t controllerActivated = 0;

uint8_t sens3Used = 0;

uint8_t sens3Solar = 0;

uint8_t sens3Buffer = 0;

float onTime = 0;

uint16_t CanBaseAdress = 0x120;


CanRxMsgTypeDef CanRx;
CanTxMsgTypeDef CanTx;
CAN_FilterConfTypeDef filterConfig;


	
/* USER CODE END PV */

void SystemClock_Config(void);
static void MX_GPIO_Init(void);
static void MX_USART2_UART_Init(void);
static void MX_SPI2_Init(void);
static void MX_CAN_Init(void);
static void MX_TIM2_Init(void);
static void MX_I2C1_Init(void);
static void MX_RTC_Init(void);

/* USER CODE BEGIN PFP */

uint8_t readCanIdDip(void);

void serialize(float data, uint8_t * serial);

void reenableCanInterrupt(CAN_HandleTypeDef* hcan);

/* USER CODE END PFP */

/**
  * @brief  The application entry point.
  *
  * @retval None
  */
int main(void)
{
  /* MCU Configuration----------------------------------------------------------*/

  /* Reset of all peripherals, Initializes the Flash interface and the Systick. */
  HAL_Init();

  /* Configure the system clock */
  SystemClock_Config();

  /* Initialize all configured peripherals */
  MX_GPIO_Init();
  MX_USART2_UART_Init();
  MX_SPI2_Init();
  MX_CAN_Init();
  MX_TIM2_Init();
  MX_I2C1_Init();
  MX_RTC_Init();
  /* USER CODE BEGIN 2 */

	
	// Initialization of the MAX PT100 Chips
	MAXSolar.SPI_Handle = &hspi2;
	MAXSolar.CS_Pin = CS_1_Pin;
	MAXSolar.CS_GPIOx = CS_1_GPIO_Port;
	MAXSolar.RDY_Pin = DRDY_1_Pin;
	MAXSolar.RDY_GPIOx = DRDY_1_GPIO_Port;
	MAXSolar.referenceResistor = 430.0;
	
	MAXSens3.SPI_Handle = &hspi2;
	MAXSens3.CS_Pin = CS_3_Pin;
	MAXSens3.CS_GPIOx = CS_3_GPIO_Port;
	MAXSens3.RDY_Pin = DRDY_3_Pin;
	MAXSens3.RDY_GPIOx = DRDY_3_GPIO_Port;
	MAXSens3.referenceResistor = 430.0;
	
	MAXBuffer.SPI_Handle = &hspi2;
	MAXBuffer.CS_Pin = CS_2_Pin;
	MAXBuffer.CS_GPIOx = CS_2_GPIO_Port;
	MAXBuffer.RDY_Pin = DRDY_2_Pin;
	MAXBuffer.RDY_GPIOx = DRDY_2_GPIO_Port;
	MAXBuffer.referenceResistor = 430.0;
	
	initialize(&MAXSolar, STANDARD_INIT);
	//initialize(&MAXSens3, STANDARD_INIT);
	initialize(&MAXBuffer, STANDARD_INIT);

	
	checkForFaults(&MAXSolar);
	//checkForFaults(&MAXSens3);
	checkForFaults(&MAXBuffer);
	
	/////////////////////////////////////////////////
	
	//CanBaseAdress = readCanIdDip();
	
	// Initialization of CAN Messages and Filter
	hcan.pTxMsg = &CanTx;
	hcan.pTxMsg->StdId = CanBaseAdress + 0x1;
	hcan.pTxMsg->ExtId = 0x0;
	hcan.pTxMsg->RTR = CAN_RTR_DATA;
	hcan.pTxMsg->IDE = CAN_ID_STD;
	hcan.pTxMsg->DLC = 5; //Datenmenge max 8
	
	hcan.pRxMsg = &CanRx;
	hcan.pRxMsg->IDE = CAN_ID_STD;
	hcan.pRxMsg->FIFONumber = CAN_FIFO0;
	hcan.pRxMsg->FMI = 1;
	
	filterConfig.FilterNumber = 1;
	filterConfig.FilterMode = CAN_FILTERMODE_IDMASK;
	filterConfig.FilterIdLow = (CanBaseAdress | 0x00F) << 5; // wegen Fehler? offset der ID um 5 Bits
	filterConfig.FilterIdHigh = (CanBaseAdress + 0x7) << 5;
	filterConfig.FilterMaskIdLow = (CanBaseAdress + 0xB) << 5;
	filterConfig.FilterMaskIdHigh = 0x0;
	filterConfig.FilterScale = CAN_FILTERSCALE_16BIT;
	filterConfig.FilterFIFOAssignment = CAN_FILTER_FIFO0;
	filterConfig.FilterActivation = ENABLE;
	filterConfig.BankNumber = 14;
	/////////////////////////////////////////////////
	
	
	// Setup Filter
	HAL_CAN_ConfigFilter(&hcan, &filterConfig);
	
	//Start Interrupt
	HAL_CAN_Receive_IT(&hcan, CAN_FIFO0);
	
	
	// Timer start
	HAL_TIM_Base_Start_IT(&htim2);
	
	

	
	

  /* USER CODE END 2 */

  /* Infinite loop */
  /* USER CODE BEGIN WHILE */
  while (1)
  {
		
	
		
		
  /* USER CODE END WHILE */

  /* USER CODE BEGIN 3 */

  }
  /* USER CODE END 3 */

}

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
/* USER CODE BEGIN 4 */

uint8_t readCanIdDip(){
	
	uint8_t canIdDip;
	
	// read in the individual DIP ID Pins
	canIdDip = (HAL_GPIO_ReadPin(C0_GPIO_Port, C0_Pin) << 0) | (HAL_GPIO_ReadPin(C1_GPIO_Port, C1_Pin) << 1) | (HAL_GPIO_ReadPin(C2_GPIO_Port, C2_Pin) << 2) | (HAL_GPIO_ReadPin(C3_GPIO_Port, C3_Pin) << 3);
	canIdDip |= (HAL_GPIO_ReadPin(C4_GPIO_Port, C4_Pin) << 4) | (HAL_GPIO_ReadPin(C5_GPIO_Port, C5_Pin) << 5) | (HAL_GPIO_ReadPin(C6_GPIO_Port, C6_Pin) << 6) | (HAL_GPIO_ReadPin(C7_GPIO_Port, C7_Pin) << 7);
	
	return canIdDip;
}


void HAL_CAN_RxCpltCallback(CAN_HandleTypeDef* hcan){
	
	
if(hcan->pRxMsg->StdId == (CanBaseAdress + MESSAGE_TRIGGER_OFFSET)){
	
		if(sens3Used == 0){
			
		hcan->pTxMsg->StdId = (CanBaseAdress + SENS_1_OFFSET);
		hcan->pTxMsg->DLC = 5;
		hcan->pTxMsg->Data[0] = MAXSolar.faultDetected;
		serialize(temperaturSolar, &(hcan->pTxMsg->Data[1]));
		HAL_CAN_Transmit(hcan, 10);
		
		} else {
		
		if(sens3Solar && !sens3Buffer){
			
		hcan->pTxMsg->StdId = (CanBaseAdress + SENS_1_OFFSET);
		hcan->pTxMsg->DLC = 5;
		hcan->pTxMsg->Data[0] = MAXSolar.faultDetected | MAXSens3.faultDetected;
		serialize(temperaturSolarMean, &(hcan->pTxMsg->Data[1]));
		HAL_CAN_Transmit(hcan, 10);		
					
			}	else {
				
		if(sens3Buffer && !sens3Solar){
			
		hcan->pTxMsg->StdId = (CanBaseAdress + SENS_1_OFFSET);
		hcan->pTxMsg->DLC = 5;
		hcan->pTxMsg->Data[0] = MAXBuffer.faultDetected | MAXSens3.faultDetected;
		serialize(temperaturBufferMean, &(hcan->pTxMsg->Data[1]));
		HAL_CAN_Transmit(hcan, 10);	
			
				}
			}		
		}

		hcan->pTxMsg->StdId = (CanBaseAdress + SENS_2_OFFSET);
		hcan->pTxMsg->DLC = 5;
		hcan->pTxMsg->Data[0] = MAXBuffer.faultDetected ;
		serialize(temperaturBuffer, &(hcan->pTxMsg->Data[1]));
		HAL_CAN_Transmit(hcan, 10);
	
		hcan->pTxMsg->StdId = (CanBaseAdress + SCHWELLE_AN_AUS_OFFSET);
		hcan->pTxMsg->DLC = 8;
		serialize(hysteresisON, &(hcan->pTxMsg->Data[0]));
		serialize(hysteresisOFF, &(hcan->pTxMsg->Data[4]));
		HAL_CAN_Transmit(hcan, 10);
	
		hcan->pTxMsg->StdId = (CanBaseAdress + INFO_RELAIS_OFFSET);
		hcan->pTxMsg->DLC = 1;
	  hcan->pTxMsg->Data[0] = relaisState;
		HAL_CAN_Transmit(hcan, 10);
		
		hcan->pTxMsg->StdId = (CanBaseAdress + TEMPERATUR_MIN_MAX_OFFSET);
		hcan->pTxMsg->DLC = 8;
		serialize(temperaturBufferMax, &(hcan->pTxMsg->Data[0]));
		serialize(temperaturSolarMin, &(hcan->pTxMsg->Data[4]));
		HAL_CAN_Transmit(hcan, 10);
			
		hcan->pTxMsg->StdId = (CanBaseAdress + REGLER_AKTIV_OFFSET);
		hcan->pTxMsg->DLC = 1;
	  hcan->pTxMsg->Data[0] = *((uint8_t *) &controllerActivated);
		HAL_CAN_Transmit(hcan, 10);
		
		hcan->pTxMsg->StdId = (CanBaseAdress + KORREKTUR_WIDERSTAND_OFFSET);
		hcan->pTxMsg->DLC = 8;
		serialize(resistanceSolar, &(hcan->pTxMsg->Data[0]));
		serialize(resistanceBuffer, &(hcan->pTxMsg->Data[4]));
		HAL_CAN_Transmit(hcan, 10);
		
		hcan->pTxMsg->StdId = (CanBaseAdress + ON_TIME_OFFSET);
		hcan->pTxMsg->DLC = 4;
		serialize(onTime, &(hcan->pTxMsg->Data[0]));
		HAL_CAN_Transmit(hcan, 10);

}	


if(hcan->pRxMsg->StdId == (CanBaseAdress + SET_SCHWELLE_AN_AUS_OFFSET)){
	float tmpON;
	float tmpOFF;
	uint8_t * ON = (uint8_t *) &tmpON;
	uint8_t * OFF = (uint8_t *) &tmpOFF;

	
	*ON = hcan->pRxMsg->Data[0];
	*(ON + 1) = hcan->pRxMsg->Data[1];
	*(ON + 2) = hcan->pRxMsg->Data[2];
	*(ON + 3) = hcan->pRxMsg->Data[3];

	*OFF = hcan->pRxMsg->Data[4];
	*(OFF + 1) = hcan->pRxMsg->Data[5];
	*(OFF + 2) = hcan->pRxMsg->Data[6];
	*(OFF + 3) = hcan->pRxMsg->Data[7];
	
	if(tmpON <= MAX_ADJUSTABLE_TEMPERATURE && tmpON >= MIN_ADJUSTABLE_TEMPERATURE){
		hysteresisON = tmpON;
	} else {
		if(tmpON > MAX_ADJUSTABLE_TEMPERATURE){
			hysteresisON = MAX_ADJUSTABLE_TEMPERATURE;
		}
		if(tmpON < MIN_ADJUSTABLE_TEMPERATURE){
			hysteresisON = MIN_ADJUSTABLE_TEMPERATURE;
		}
	}

	
	if(tmpOFF <= MAX_ADJUSTABLE_TEMPERATURE && tmpOFF >= MIN_ADJUSTABLE_TEMPERATURE){
		hysteresisOFF = tmpOFF;
	} else {
		if(tmpOFF > MAX_ADJUSTABLE_TEMPERATURE){
			hysteresisOFF = MAX_ADJUSTABLE_TEMPERATURE;
		}
		if(tmpOFF < MIN_ADJUSTABLE_TEMPERATURE){
			hysteresisOFF = MIN_ADJUSTABLE_TEMPERATURE;
		}
	}
	
	
		hcan->pTxMsg->StdId = (CanBaseAdress + SCHWELLE_AN_AUS_OFFSET);
		hcan->pTxMsg->DLC = 8;
		serialize(hysteresisON, &(hcan->pTxMsg->Data[0]));
		serialize(hysteresisOFF, &(hcan->pTxMsg->Data[4]));
		HAL_CAN_Transmit(hcan, 10);
	
}
	
if(hcan->pRxMsg->StdId == (CanBaseAdress + SET_TEMPERATUR_MIN_MAX_OFFSET)){
	float tmpMAX;
	float tmpMIN;
	uint8_t * MAX = (uint8_t *) &tmpMAX;
	uint8_t * MIN = (uint8_t *) &tmpMIN;
	
	*MAX = hcan->pRxMsg->Data[0];
	*(MAX + 1) = hcan->pRxMsg->Data[1];
	*(MAX + 2) = hcan->pRxMsg->Data[2];
	*(MAX + 3) = hcan->pRxMsg->Data[3];

	*MIN = hcan->pRxMsg->Data[4];
	*(MIN + 1) = hcan->pRxMsg->Data[5];
	*(MIN + 2) = hcan->pRxMsg->Data[6];
	*(MIN + 3) = hcan->pRxMsg->Data[7];
	
	
		if(tmpMAX <= MAX_ADJUSTABLE_TEMPERATURE && tmpMAX >= MIN_ADJUSTABLE_TEMPERATURE){
		temperaturBufferMax = tmpMAX;
		} else {
		if(tmpMAX > MAX_ADJUSTABLE_TEMPERATURE){
			temperaturBufferMax = MAX_ADJUSTABLE_TEMPERATURE;
		}
		if(tmpMAX < MIN_ADJUSTABLE_TEMPERATURE){
			temperaturBufferMax = MIN_ADJUSTABLE_TEMPERATURE;
		}
	}
		
		if(tmpMIN <= MAX_ADJUSTABLE_TEMPERATURE && tmpMIN >= MIN_ADJUSTABLE_TEMPERATURE){
		temperaturSolarMin = tmpMIN;
		} else {
		if(tmpMIN > MAX_ADJUSTABLE_TEMPERATURE){
			temperaturSolarMin = MAX_ADJUSTABLE_TEMPERATURE;
		}
		if(tmpMIN < MIN_ADJUSTABLE_TEMPERATURE){
			temperaturSolarMin = MIN_ADJUSTABLE_TEMPERATURE;
		}
	}
	
	
		hcan->pTxMsg->StdId = (CanBaseAdress + TEMPERATUR_MIN_MAX_OFFSET);
		hcan->pTxMsg->DLC = 8;
		serialize(temperaturBufferMax, &(hcan->pTxMsg->Data[0]));
		serialize(temperaturSolarMin, &(hcan->pTxMsg->Data[4]));
		HAL_CAN_Transmit(hcan, 10);
	
}

if(hcan->pRxMsg->StdId == (CanBaseAdress + SET_REGLER_AKTIV_OFFSET)){
	
	controllerActivated = hcan->pRxMsg->Data[0];
	
		hcan->pTxMsg->StdId = (CanBaseAdress + 0x6);
		hcan->pTxMsg->DLC = 1;
	  hcan->pTxMsg->Data[0] = *((uint8_t *) &controllerActivated);
		HAL_CAN_Transmit(hcan, 10);
	
}
	

if(hcan->pRxMsg->StdId == (CanBaseAdress + SET_KORREKTUR_WIDERSTAND_OFFSET)){
	

	uint8_t * SOL = (uint8_t *) &resistanceSolar;
	uint8_t * BUF = (uint8_t *) &resistanceBuffer;
	
	*SOL = hcan->pRxMsg->Data[0];
	*(SOL + 1) = hcan->pRxMsg->Data[1];
	*(SOL + 2) = hcan->pRxMsg->Data[2];
	*(SOL + 3) = hcan->pRxMsg->Data[3];

	*BUF = hcan->pRxMsg->Data[4];
	*(BUF + 1) = hcan->pRxMsg->Data[5];
	*(BUF + 2) = hcan->pRxMsg->Data[6];
	*(BUF + 3) = hcan->pRxMsg->Data[7];
	
	
	hcan->pTxMsg->StdId = (CanBaseAdress + KORREKTUR_WIDERSTAND_OFFSET);
	hcan->pTxMsg->DLC = 8;
	serialize(resistanceSolar, &(hcan->pTxMsg->Data[0]));
	serialize(resistanceBuffer, &(hcan->pTxMsg->Data[4]));
	HAL_CAN_Transmit(hcan, 10);
	
}

if(hcan->pRxMsg->StdId == (CanBaseAdress + SET_SENS_3_STATUS_OFFSET)){
	
	sens3Used = hcan->pRxMsg->Data[0];
	sens3Buffer = hcan->pRxMsg->Data[1];
	sens3Solar = hcan->pRxMsg->Data[2];
	
}
	
	reenableCanInterrupt(hcan);
	
}


void reenableCanInterrupt(CAN_HandleTypeDef* hcan){
	
		if(hcan->State == HAL_CAN_STATE_BUSY_TX){
			hcan->State = HAL_CAN_STATE_BUSY_TX_RX0; 
		} else {
			hcan->State = HAL_CAN_STATE_BUSY_RX0;
			hcan->ErrorCode = HAL_CAN_ERROR_NONE;
		
			__HAL_CAN_ENABLE_IT(hcan, CAN_IT_EWG);		
			__HAL_CAN_ENABLE_IT(hcan, CAN_IT_EPV);
			__HAL_CAN_ENABLE_IT(hcan, CAN_IT_BOF);
			__HAL_CAN_ENABLE_IT(hcan, CAN_IT_LEC);
			__HAL_CAN_ENABLE_IT(hcan, CAN_IT_ERR);
			__HAL_CAN_ENABLE_IT(hcan, CAN_IT_EWG);
		
	}
	
	__HAL_CAN_ENABLE_IT(hcan, CAN_IT_FMP0);
	
}


void serialize(float data, uint8_t * serial){
	
		*serial = *((uint8_t *) &data);
		*(serial + 1) = *(((uint8_t *) &data) + 1);
		*(serial + 2) = *(((uint8_t *) &data) + 2);
		*(serial + 3) = *(((uint8_t *) &data) + 3);
	
}

/* USER CODE END 4 */
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
