preal97/VMCB/Software/Solarregler/Solarregler.ioc

Mcu.UserName=STM32F103RBTx
PA10.GPIO_Label=C2
PA10.Signal=GPIO_Input
PA11.GPIO_Label=C1
PA11.Signal=GPIO_Input
PA12.GPIO_Label=C0
PA12.Signal=GPIO_Input
PA13.GPIO_Label=TMS
PA13.Signal=SYS_JTMS-SWDIO
PA14.GPIO_Label=TCK
PA14.Signal=SYS_JTCK-SWCLK
PA15.Signal=SYS_JTDI
PA2.GPIO_Label=USART_TX
PA2.Signal=USART2_TX
PA3.GPIO_Label=USART_RX
PA3.Signal=USART2_RX
PA4.GPIO_Label=LD2
PA4.Signal=GPIO_Output
PA5.GPIO_Label=LD1
PA5.Signal=GPIO_Output
PA6.GPIO_Label=DRDY_1
PA6.Signal=GPIO_Input
PA7.GPIO_Label=CS_1
PA7.Signal=GPIO_Output
PA8.GPIO_Label=C4
PA8.Signal=GPIO_Input
PA9.GPIO_Label=C3
PA9.Signal=GPIO_Input
PB0.GPIO_Label=DRDY_3
PB0.Signal=GPIO_Input
PB1.GPIO_Label=CS_3
PB1.Signal=GPIO_Output
PB11.Signal=GPIO_Input
PB12.Signal=GPIO_Output
PB13.Signal=SPI2_SCK
PB14.Signal=SPI2_MISO
PB15.Signal=SPI2_MOSI
PB3.GPIO_Label=SWO
PB3.Signal=SYS_JTDO-TRACESWO
PB4.Signal=SYS_NJTRST
PB5.Signal=I2C1_SMBA
PB6.Signal=I2C1_SCL
PB7.Signal=I2C1_SDA
PB8.Signal=CAN_RX
PB9.Signal=CAN_TX
PC13-TAMPER-RTC.GPIO_Label=B1 [Blue PushButton]
PC13-TAMPER-RTC.Signal=GPXTI13
PC14-OSC32_IN.Signal=RCC_OSC32_IN
PC15-OSC32_OUT.Signal=RCC_OSC32_OUT
PC4.GPIO_Label=DRDY_2
PC4.Signal=GPIO_Input
PC5.GPIO_Label=CS_2
PC5.Signal=GPIO_Output
PC7.GPIO_Label=C7
PC7.Signal=GPIO_Input
PC8.GPIO_Label=C6
PC8.Signal=GPIO_Input
PC9.GPIO_Label=C5
PC9.Signal=GPIO_Input
PD0-OSC_IN.Signal=RCC_OSC_IN
PD1-OSC_OUT.Signal=RCC_OSC_OUT
