preal97/VMCB/Software/Solarregler/Src/MAX31865.c

#include "MAX31865.h"
#include "stm32f1xx_hal.h"


////////////////////////////////////////////////////////////////////////////////////////
// MAX31865: Handle Struct for MAX31865 Chip
// setupCodes: Bits to set in INIT. See Reference Manual or .h for more information
//

void initialize(MAX31865_TypeDef * MAX31865, uint8_t setupCodes){ // writes to configuration register of the Chip with the given setup codes
	
	singleByteWrite(CONFIG_REGISTER_WRITE, setupCodes, MAX31865->SPI_Handle, MAX31865->CS_GPIOx, MAX31865->CS_Pin);
	singleByteWrite(HIGH_FAULT_THRESHOLD_MSB_WRITE, 0x7F, MAX31865->SPI_Handle, MAX31865->CS_GPIOx, MAX31865->CS_Pin);
	singleByteWrite(HIGH_FAULT_THRESHOLD_LSB_WRITE, 0xFF, MAX31865->SPI_Handle, MAX31865->CS_GPIOx, MAX31865->CS_Pin);
	singleByteWrite(LOW_FAULT_THRESHOLD_MSB_WRITE, 0x00, MAX31865->SPI_Handle, MAX31865->CS_GPIOx, MAX31865->CS_Pin);
	singleByteWrite(LOW_FAULT_THRESHOLD_LSB_WRITE, 0xFF, MAX31865->SPI_Handle, MAX31865->CS_GPIOx, MAX31865->CS_Pin);

}


///////////////////////////////////////////////////////////////////////////////////////
// MAX31865: Handle Struct for MAX31865 Chip

void checkForFaults(MAX31865_TypeDef * MAX31865){
	
	MAX31865->faultDetected = singleByteRead(FAULT_STATUS_REGISTER_READ, MAX31865->SPI_Handle, MAX31865->CS_GPIOx, MAX31865->CS_Pin);
	if(MAX31865->faultDetected >= 1){
		MAX31865->faultDetected = 1;
	}
}



///////////////////////////////////////////////////////////////////////////////////////
// MAX31865: Handle Struct for MAX31865 Chip


float measureTemperatureOneShotConverted(MAX31865_TypeDef * MAX31865){  //measures temperature and gives back value in °C
	double temperature;
	double percentage;
	double resistance;
	
	percentage = (double)measureTemperatureOneShotAdcRaw(MAX31865) / (double)((1 << 15) - 1);
	
	resistance = (percentage * MAX31865->referenceResistor);
	
	temperature = (resistance - 100.0) * 2.597;
	
	return (float)temperature;
}

///////////////////////////////////////////////////////////////////////////////////////
// MAX31865: Handle Struct for MAX31865 Chip
// resistance: correction for leads/resistance of leads
float measureTemperatureOneShotConvertedCorrected(MAX31865_TypeDef * MAX31865, float resistance){
	float temperature;
	
	temperature = measureTemperatureOneShotConverted(MAX31865) - (resistance * DEGREES_PER_RESISTANCE);

	return temperature;
}


///////////////////////////////////////////////////////////////////////////////////////
// MAX31865: Handle Struct for MAX31865 Chip

uint16_t measureTemperatureOneShotAdcRaw(MAX31865_TypeDef * MAX31865){
	uint16_t adcCount;
	
	singleByteWrite(CONFIG_REGISTER_WRITE, ONE_SHOT|STANDARD_INIT, MAX31865->SPI_Handle, MAX31865->CS_GPIOx, MAX31865->CS_Pin);
	
	while(HAL_GPIO_ReadPin(MAX31865->RDY_GPIOx, MAX31865->RDY_Pin) == 1);
	
	adcCount = (singleByteRead(RTD_MSB_REGISTER_READ, MAX31865->SPI_Handle, MAX31865->CS_GPIOx, MAX31865->CS_Pin) << 8);
	
	adcCount |= singleByteRead(RTD_LSB_REGISTER_READ, MAX31865->SPI_Handle, MAX31865->CS_GPIOx, MAX31865->CS_Pin);
	
	adcCount >>= 1;
	
	
	return adcCount;
}

///////////////////////////////////////////////////////////////////////////////////////
// address: adress of register to write
// data: data to write to the register
// SPI: SPI Handle to send data
// CS_GPIOx: GPIO Handle for port of CS pin
// CS_Pin: Number of CS pin

void singleByteWrite(uint8_t address, uint8_t data, SPI_HandleTypeDef* SPI, GPIO_TypeDef *CS_GPIOx, uint16_t CS_Pin){
	
	HAL_GPIO_WritePin(CS_GPIOx, CS_Pin, GPIO_PIN_RESET);
	
	HAL_SPI_Transmit(SPI, &address, sizeof(address), HAL_MAX_DELAY);
	
	HAL_SPI_Transmit(SPI, &data, sizeof(data), HAL_MAX_DELAY);
	
	HAL_GPIO_WritePin(CS_GPIOx, CS_Pin, GPIO_PIN_SET);
	
}


///////////////////////////////////////////////////////////////////////////////////////
// address: adress of register to write
// SPI: SPI Handle to send data
// CS_GPIOx: GPIO Handle for port of CS pin
// CS_Pin: Number of CS pin

uint8_t singleByteRead(uint8_t address, SPI_HandleTypeDef* SPI, GPIO_TypeDef *CS_GPIOx, uint16_t CS_Pin){
	
	uint8_t sendData[2];
	uint8_t receiveData[2];
	
	sendData[0] = address;
	sendData[1] = 0x00; // Dummy
	
	HAL_GPIO_WritePin(CS_GPIOx, CS_Pin, GPIO_PIN_RESET);
	
	HAL_SPI_TransmitReceive(SPI, sendData, receiveData, sizeof(receiveData), HAL_MAX_DELAY);
	
	HAL_GPIO_WritePin(CS_GPIOx, CS_Pin, GPIO_PIN_SET);
	
	return receiveData[1];
	
}


////////////////////////////////////////////////////////////////////////////////////////
