preal97/VMCB/(commit log)

2018-12-06 2 Sensoren Implementiert
    [Solarregler.sch]
2018-12-06 Can implementiert
    [Solarregler.sch]
2018-12-09 Änderungen von UNI auf GIT
    [Bauteilliste Solarregler V0.1.xlsx]
2018-12-09 CAN Filter implementiert + Fault erkennung der Sensoren
2018-12-10 Layout update nach Gespräch mit ME
    [Solarregler.brd, Solarregler.sch]
2018-12-11 can interrupt reenable funktion
2018-12-17 MAX MIN und Regler Aktiv implementiert
2018-12-21 RTC, Can und mehr
2018-12-24 Port to STM32F105RBT6
2019-01-18 Serializer, ON-Time, Resistance Correction added
    [MAX31865.c, MAX31865.h, main.c, main.h]
