preal97/VMCB/(notices)

Notices in the files:
Software/Solarregler/Src/main.c:
(C) COPYRIGHT STMicroelectronics *****END OF FILE
